seanmason/skadis-designs/animation/v07-assembly/poster.jpg

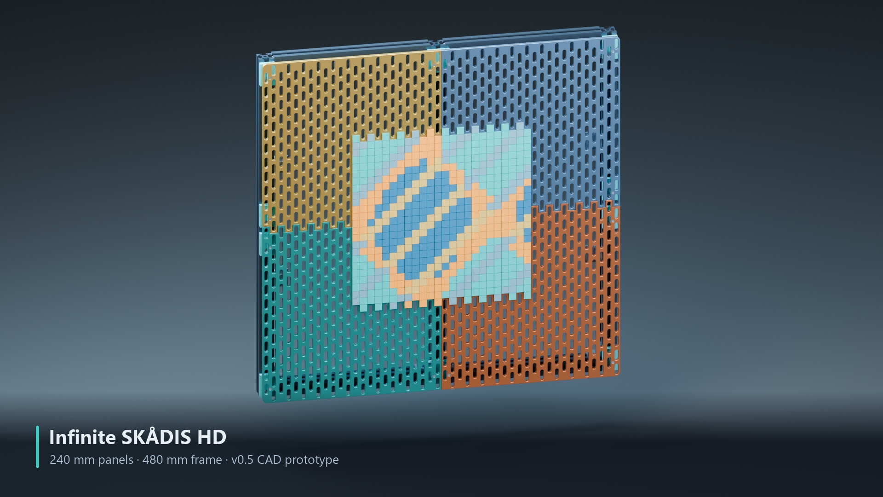
animation/v07-assembly/poster.jpg
