seanmason/skadis-designs/animation/v03-reveal/qa-contact-sheet.jpg

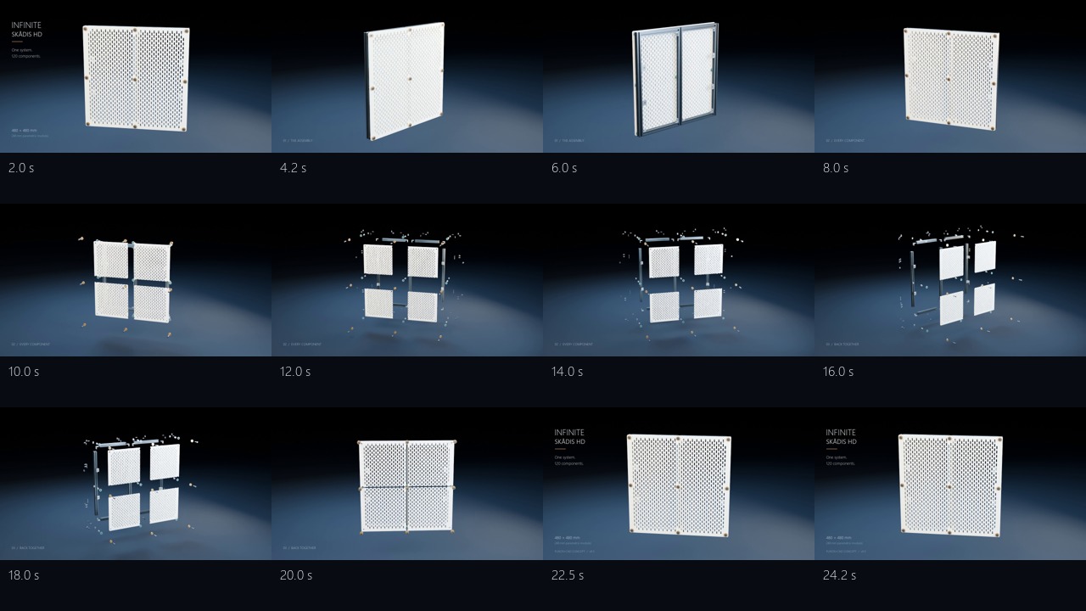
animation/v03-reveal/qa-contact-sheet.jpg
