seanmason/skadis-designs/docs/menards-morton-grove-hardware.md

# Menards Morton Grove hardware lookup

Checked live with **Morton Grove** selected, 2026-10-31 (approximately 9:15–9:35 PM Central). Prices below are before tax and before mail-in rebates. Stock means displayed retail packs, not individual fasteners; inventory can change before arrival. Nothing ordered or reserved.

Store: [6301 Oakton St, Morton Grove, IL 60053](https://www.menards.com/store-details/store.html?store=3523). Main telephone 847-966-1600; hardware department **847-966-2050**. The store page showed Saturday closing at 10 PM.

All four verified stocked items below are **Aisle 183, Section B**.

| Item | Model / SKU | Pack price | Displayed stock | Drawer | Design relevance |
|---|---|---:|---:|---|---|
| [M5-0.80 x 12 mm Phillips flat-head, zinc](https://www.menards.com/main/hardware/fasteners-connectors/screws/machine-screws/midwest-fastener-reg-5mm-0-80-x-12mm-phillips-drive-zinc-flat-head-machine-screw-2-c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) | 88582 / 2012304 | $0.99 / 2 | 3 packs = 6 screws | 89882 | Nominal thread/length/head-style match to the 12 existing carrier fixings. Measure actual head diameter and angle against the 9.4 mm CAD pocket; listing gives no head drawing or rated class. Stock short by 6 screws. |
| [M2-0.40 hex nuts, zinc Class 8](https://www.menards.com/main/hardware/fasteners-connectors/nuts/hex-jam-nuts/midwest-fastener-reg-metric-zinc-class-8-coarse-thread-hex-nuts/87285/p-1444440165809-c-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) | 87285 / 2029854 | $0.59 / 2 | 4 packs = 8 nuts | 89768 | Current M2 design needs 16. Buy only for the M2 trial; dimensions must fit its 4.3 mm track and nominal 1.6 mm nut height. |
| [M3-0.50 x 20 mm hex-drive flat-head, black](https://www.menards.com/main/hardware/fasteners-connectors/screws/socket-cap-screws/midwest-fastener-reg-3mm-0-50-x-20mm-plain-hex-drive-flat-head-coarse-thread-sock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) | 88689 / 2012442 | $1.69 / 2 | 14 packs = 28 screws | 89892 | Candidate for the solid-land revision, NOT a substitution in v0.5. Listing head diameter 5.7 mm, height 1.86 mm, 2 mm hex key. Eight packs give 16 screws for four panels ($13.52). Final stack/engagement must be checked in the revised carrier. |
| [M3-0.50 hex nuts, zinc Class 8](https://www.menards.com/main/hardware/fasteners-connectors/nuts/hex-jam-nuts/midwest-fastener-reg-metric-zinc-class-8-coarse-thread-hex-nuts/87293/p-1444440147817-c-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) | 87293 / 2029862 | $0.59 / 2 | 8 packs = 16 nuts | 89768 | Candidate for the solid-land revision only. DIN 934, 5.5 mm across flats. Eight packs give 16 nuts ($4.72). |

An alternative [M3-0.50 x 20 mm Phillips flat-head](https://www.menards.com/main/hardware/fasteners-connectors/screws/machine-screws/midwest-fastener-reg-3mm-0-50-x-20mm-phillips-drive-zinc-flat-head-machine-screw-3-c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), model 88569 / SKU 2012289, was $0.99 per 3, five packs (15 screws) in stock, drawer 89881. Its exact head envelope was not supplied. Prefer a consistent head type after measuring a sample.

The [20-pack M5 Phillips flat-head](https://www.menards.com/main/hardware/fasteners-connectors/screws/machine-screws/midwest-fastener-reg-5mm-0-80-x-12mm-phillips-drive-zinc-flat-head-machine-screw-20-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), model 72447, was $5.49 but pickup disabled / delivery only, so it is not a confirmed on-site purchase.

## Not a complete on-site bill of materials

- The site's M2 search returned [M2 x 20 slotted **pan-head** screws](https://www.menards.com/main/hardware/fasteners-connectors/screws/machine-screws/midwest-fastener-reg-2mm-0-40-x-20mm-slotted-drive-zinc-pan-head-machine-screw-2-cou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), SKU 2029856, 12 two-packs at $0.89. These are **not** compatible replacements for the current flush countersunk seats. No matching M2 flat-head product was verified.
- The frame requires 24 nominal M5 x 8 button-head screws. Site search found an M5 x 8 **truss-head** option (SKU 2012349), not the modeled button head. Do not substitute without head/tool-clearance verification.
- The assembly needs 36 profile-specific M5 channel nuts: 12 front-carrier nuts plus 24 side-joint/wall-tab nuts. No suitable Menards extrusion nut was verified. The CAD's 8.8 x 12 x 2.7 mm thin-nut envelope is provisional for the measured sloped channel. Woodworking four-prong tee nuts are not substitutes.
- Metal corner brackets, flush wall tabs and four wall-anchor locations are still provisional. Anchor type, length and count cannot be selected from an unspecified wall substrate/load. Do not treat the head-only reference geometry as a purchase specification.
- The optional existing handling tool uses two M2 x 6 flat-head screws; a matching Menards item was not verified.

The M3 items are useful **sample hardware** for a revised mounting station. A complete panel/carrier/jig revision and load qualification remain pending the mounting-layout choice, filament and load target described in [the mounting study](mounting-revision-study.md).

## Online alternatives checked 2026-10-31

Amazon guest product pages were checked with **Morton Grove 60053** selected, around 9:50 PM Central. ZIP and Prime membership have been requested but not confirmed by the user. These are displayed delivery estimates, not reservations or checkout guarantees. Prices exclude tax. No purchases made.

| Product | Pack / price | Delivery displayed | Use and qualification |
|---|---|---|---|
| [Fullerkreg M5-0.8 x 8 button-head, ISO 7380, stainless](https://www.amazon.com/dp/B07H18YDYB) | 100 / $8.89 | Prime Sunday Nov 1; nonmember Thursday Nov 5 with eligible $35 order | 24 required in current four-panel assembly. Listing specifies 8 mm under-head length, 3 mm hex drive, fully threaded, A2 stainless. Best straightforward fast-delivery candidate. Final engagement depends on selected channel nut and actual bracket thickness. |
| [QWUEE M5-0.8 x 12 Phillips flat-head, stainless](https://www.amazon.com/dp/B0D8PPQPBX) | 30 / $6.89 | Prime Monday Nov 2; nonmember Thursday Nov 5 with eligible $35 order | 12 current carrier screws. Thread, length and head style match nominally; head diameter and countersink angle are not specified. Verify against 9.4 mm CAD seat before bulk use. Title incorrectly says UNC, but bullet explicitly specifies metric 5 mm diameter / 0.8 mm pitch / 12 mm including head. |
| [QWUEE M2-0.4 x 20 Phillips flat-head, stainless](https://www.amazon.com/dp/B0D8PRMRRV) | 50 / $7.29 | Prime Monday Nov 2; nonmember Thursday Nov 5 with eligible $35 order | 16 current panel screws, only for M2 prototypes pending mounting revision. Confirm head fits 4.0 mm seat. Listing's UNC wording conflicts with explicit metric diameter/pitch; not a dimensionally certified supplier drawing. |
| [ZQZ metric hex nut assortment, stainless](https://www.amazon.com/dp/B0B17LL6WZ) | 370 / $15.99 | Prime Sunday Nov 1; nonmember Thursday Nov 5 with eligible $35 order | Includes 70 M2 and 70 M3, enough for either 16-nut panel-mount option. Check across-flats and height against printed capture before use. Its ordinary M5 hex nuts are NOT substitutes for extrusion channel nuts. |
| [QWUEE M3-0.5 x 20 Phillips flat-head, stainless](https://www.amazon.com/dp/B0D8PQTP94) | 50 / $7.29 | Thursday Nov 5 shown; no earlier Prime promise visible | Conditional candidate for proposed M3 solid-land revision, not current v0.5. Only one pack shown. Final head dimensions and carrier stack remain unqualified. |

The M5 x 8 screws, M5 x 12 screws, M2 x 20 screws and nut assortment total **$39.06 before tax**, but this is a prototype sourcing basket, not a complete or released assembly BOM. Do not buy both panel-screw diameters assuming interchangeability.

### Extrusion nuts: unresolved fit

[Boeray 20-M5 slide-in nuts, 50 pack](https://www.amazon.com/dp/B01GCDG2QO) were $7.99, with Prime Sunday Nov 1 / nonmember Thursday Nov 5 delivery displayed. This is **not a qualified recommendation**. The bullet claims 10 mm length, 9 mm width, 4.5 mm height with a 6 x 1.5 mm step, while the description says 10 x 10 x 5 mm. It is end-loaded, not front-loaded. Neither conflicting envelope establishes clearance in the measured sloped channel, bearing under its lips, or adequate screw engagement without bottoming. The assembly needs 36 verified channel nuts. A physical sample and section comparison are needed before choosing this product or revising the nut envelope.

### Fast alternative: McMaster-Carr

McMaster's [delivery policy](https://www.mcmaster.com/info/delivery) says 98% of items ship from stock and most orders arrive same or next day. This is a general policy, not an item-specific delivery promise. Its [Chicago contact page](https://www.mcmaster.com/contact) lists will call at **600 N County Line Rd, Elmhurst IL 60126**, phone **630-600-3600**; Sunday hours **7 AM–2 PM**, Monday–Thursday **6 AM–10 PM**, Friday **6 AM–6 PM**, Saturday **7 AM–2 PM**. Confirm order readiness before travel. Exact McMaster SKUs, stock and shipment dates were not verified in this lookup.

Wall anchors and final metal bracket specifications remain unresolved as above. None of these listings establishes an allowable load for the printed assembly.
