seanmason/skadis-designs/animation/v03-reveal/poster.png

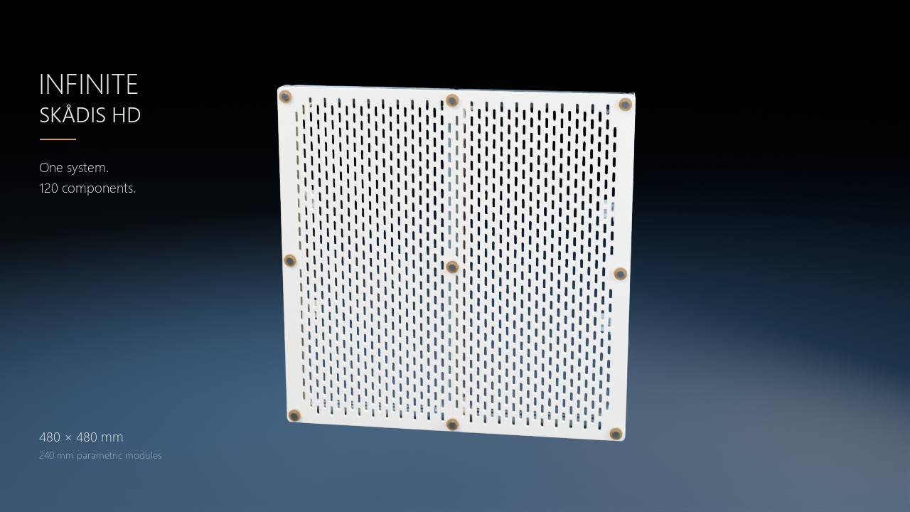
animation/v03-reveal/poster.png
