seanmason/skadis-designs/animation/v04-metallic/contact-sheet.jpg

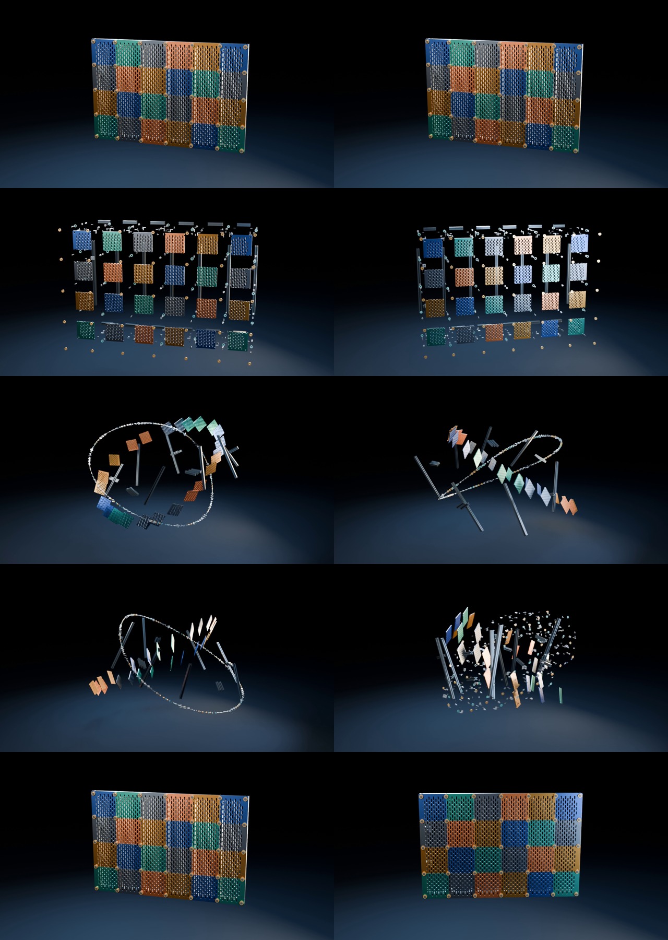
animation/v04-metallic/contact-sheet.jpg
