seanmason/skadis-designs/animation/v04-metallic/whirlwind.png

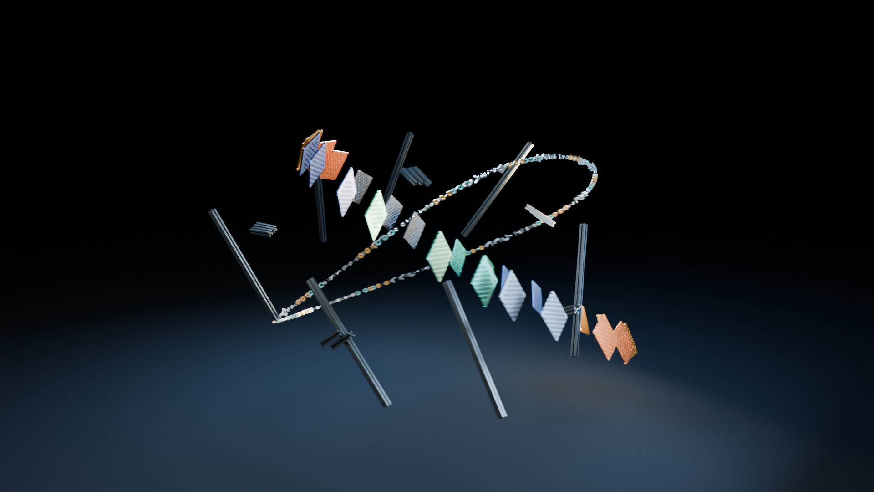
animation/v04-metallic/whirlwind.png
