seanmason/skadis-designs/animation/v04-review/exploded.png

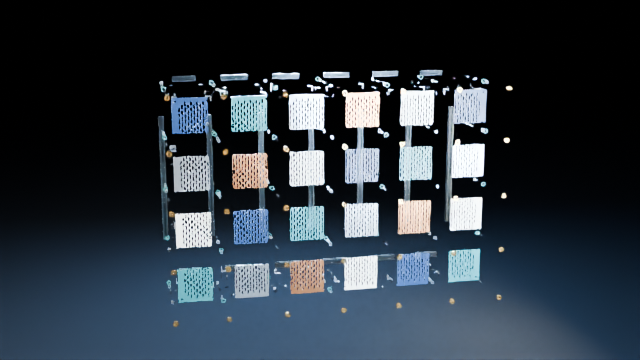
animation/v04-review/exploded.png
