seanmason/skadis-designs/animation/v05-smooth/regression-contact-sheet.jpg

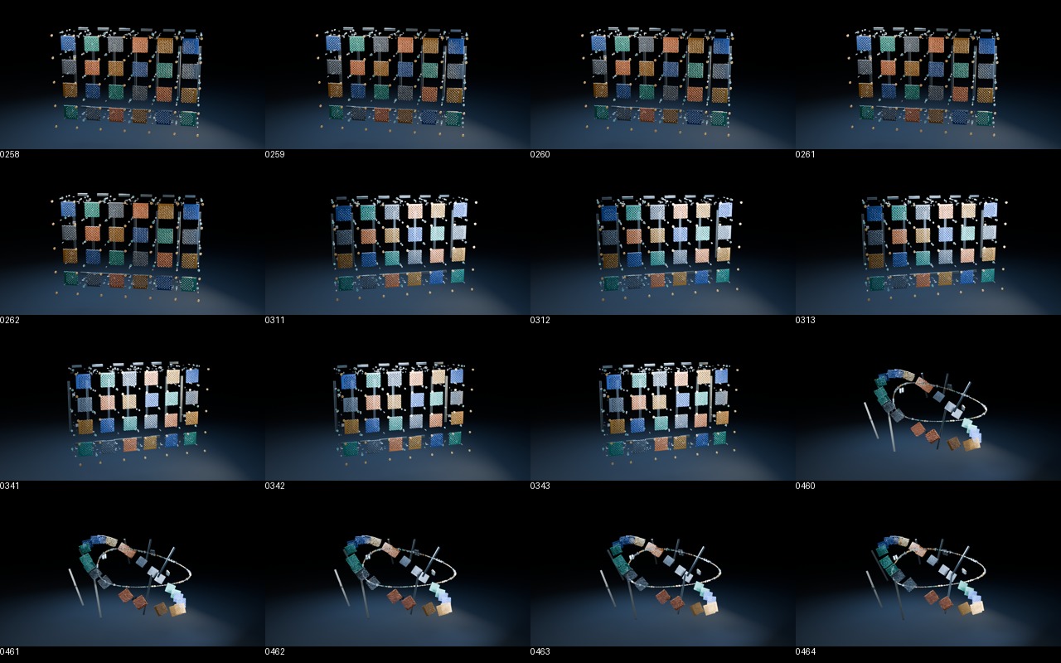
animation/v05-smooth/regression-contact-sheet.jpg
