seanmason/skadis-designs/models/mounting-study/comparison.png

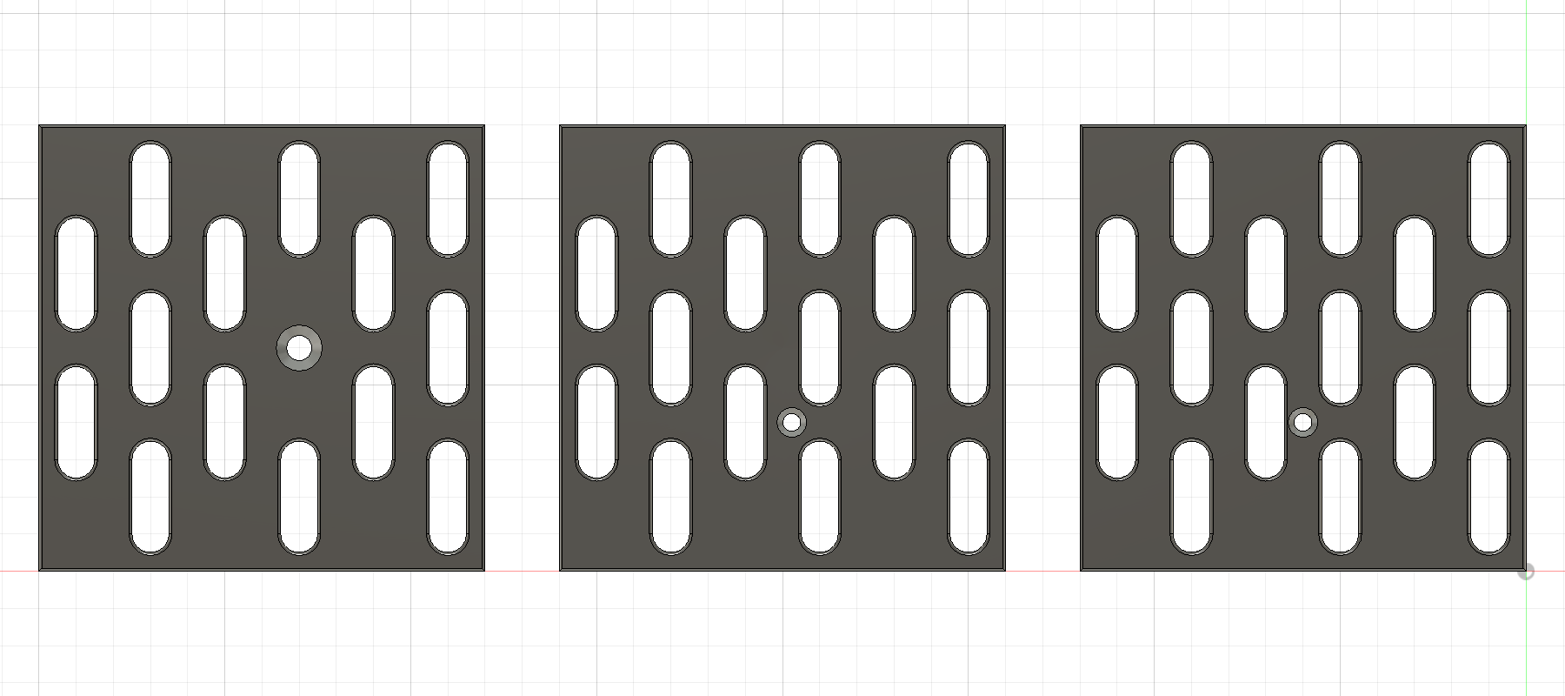
models/mounting-study/comparison.png
