seanmason/skadis-designs/models/v04-study/front.png

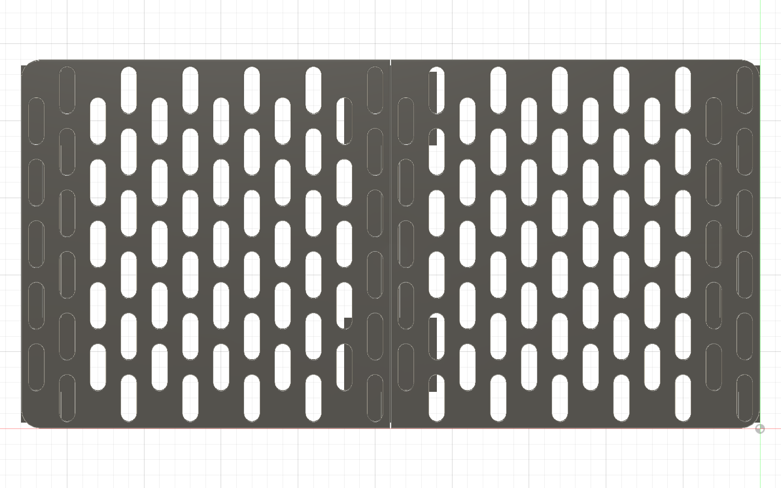
models/v04-study/front.png
