seanmason/skadis-designs/models/v04-study/study.png

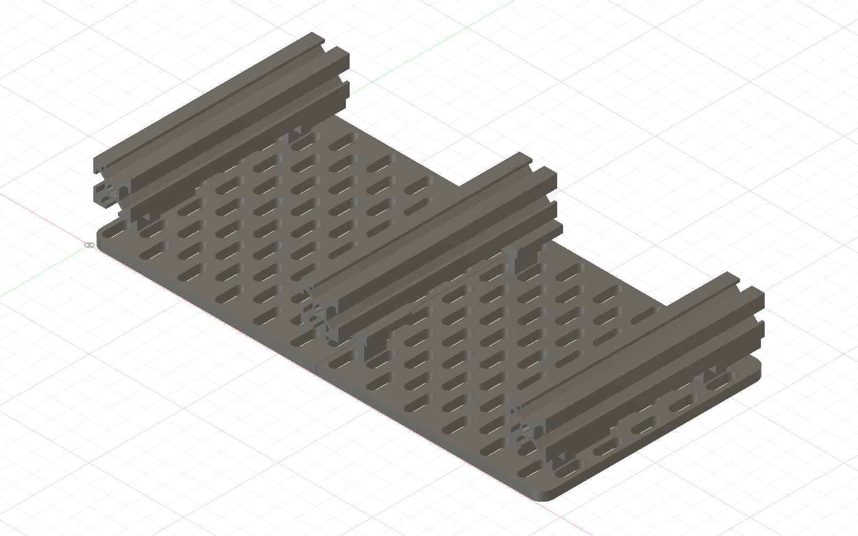
models/v04-study/study.png
