seanmason/skadis-designs/models/v061/fit-kit/preview.png

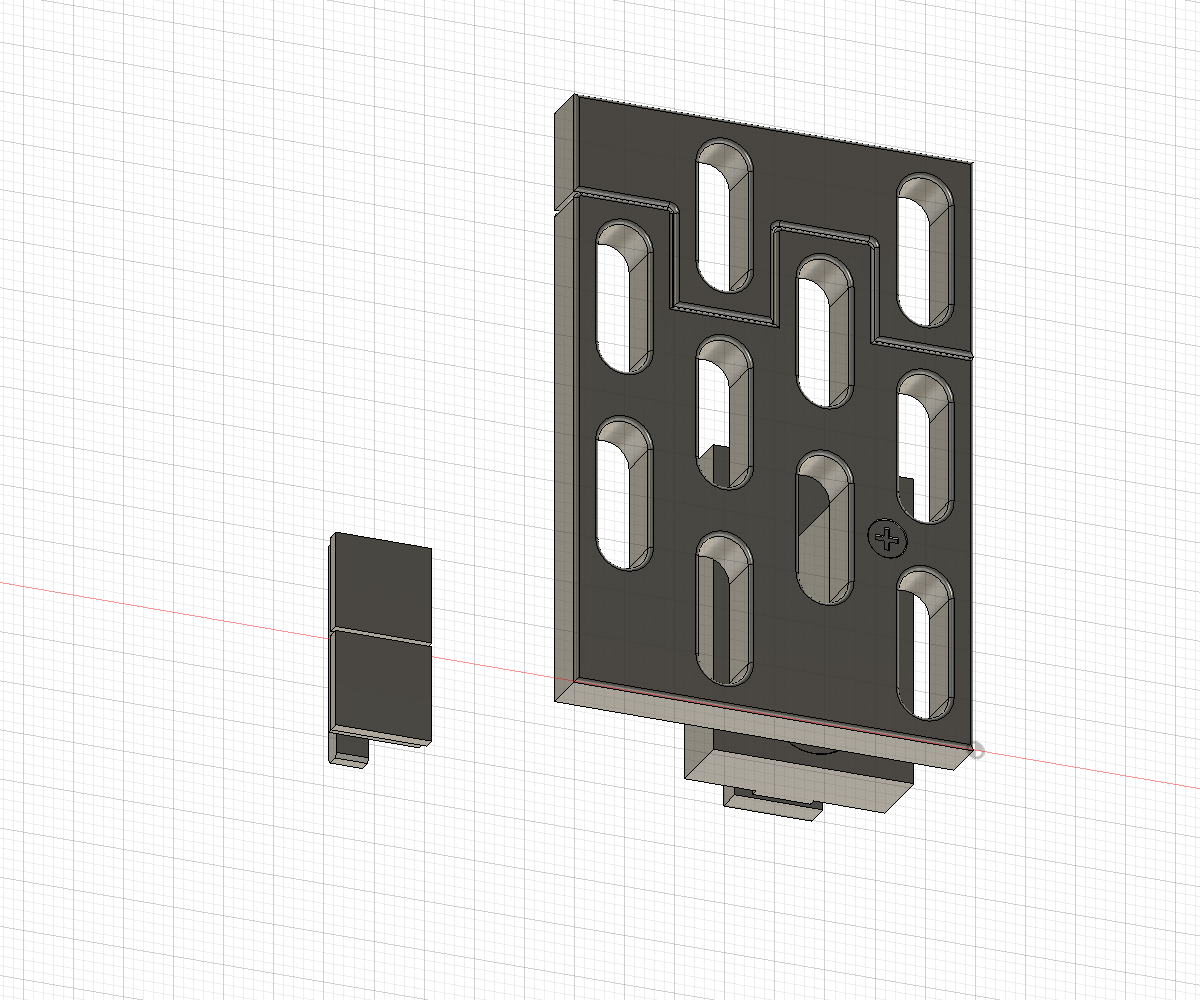
models/v061/fit-kit/preview.png
