seanmason/skadis-designs/previews/master-rear.png

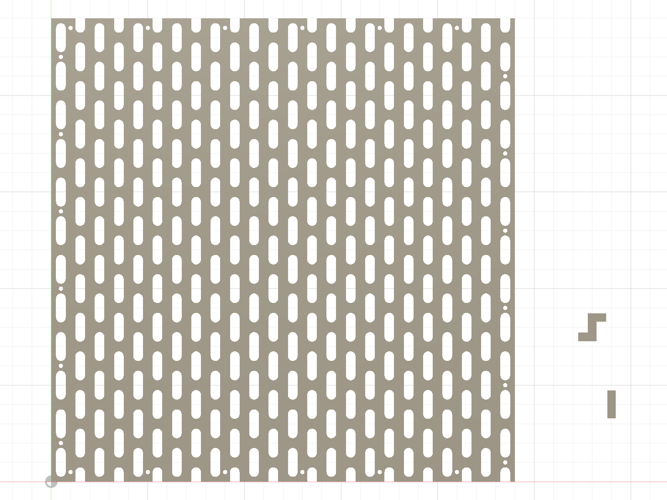
previews/master-rear.png
