seanmason/skadis-designs/previews/v02-face.png

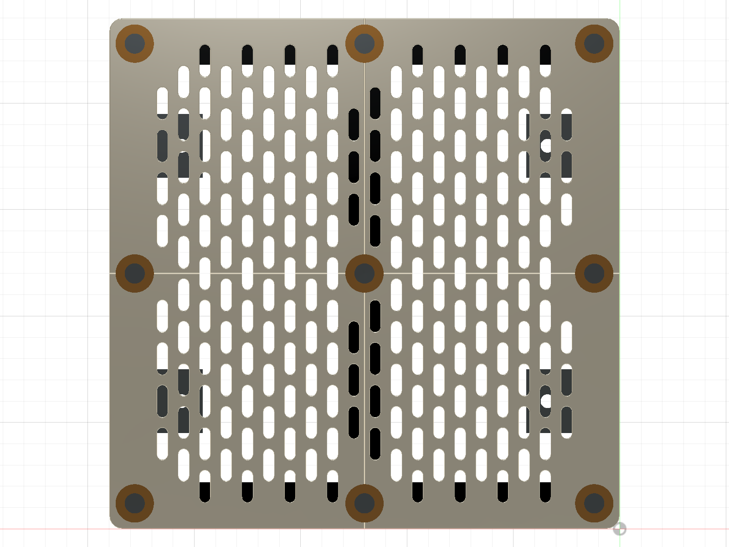
previews/v02-face.png
