seanmason/skadis-designs/previews/v02-rear.png

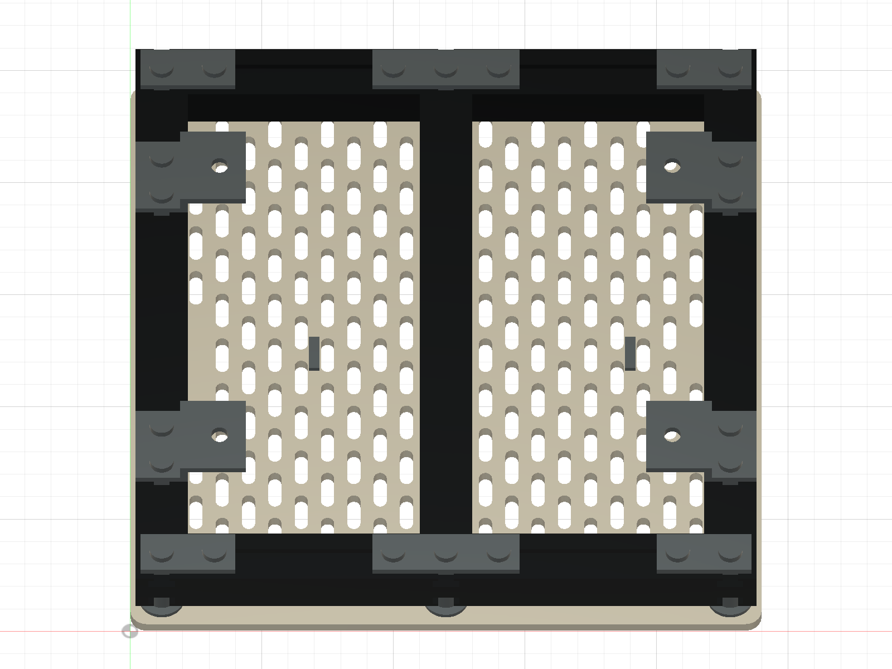
previews/v02-rear.png
