seanmason/skadis-designs/previews/v02-side.png

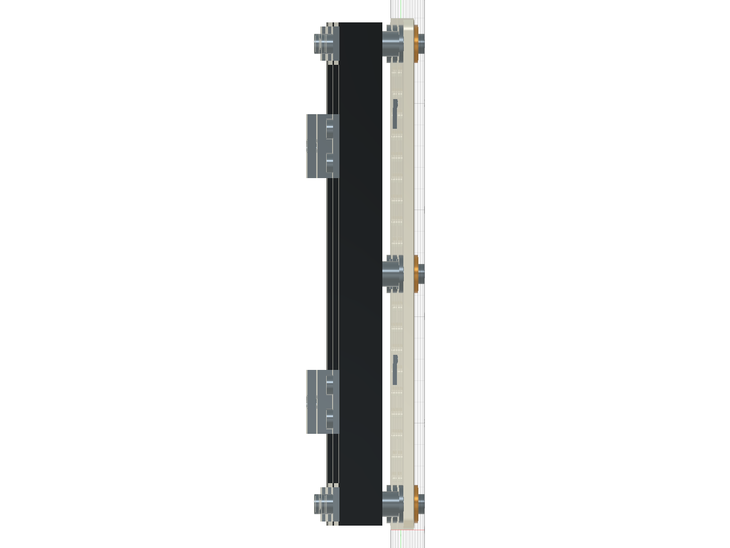
previews/v02-side.png
