seanmason/skadis-designs/previews/v03-bare-frame.png

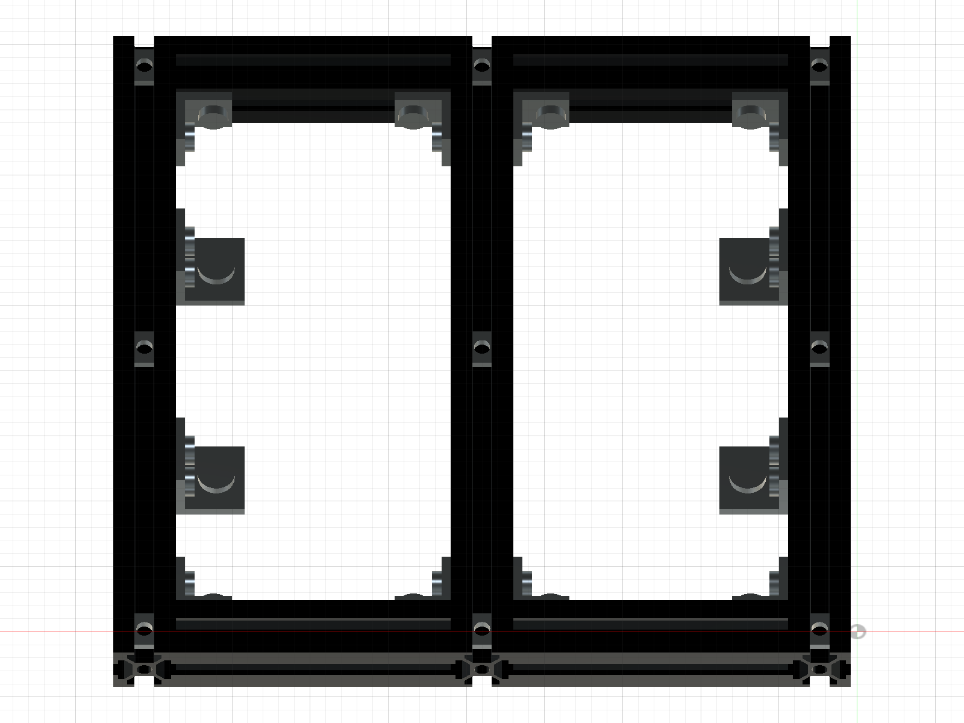
previews/v03-bare-frame.png
