seanmason/skadis-designs/previews/v03-front.png

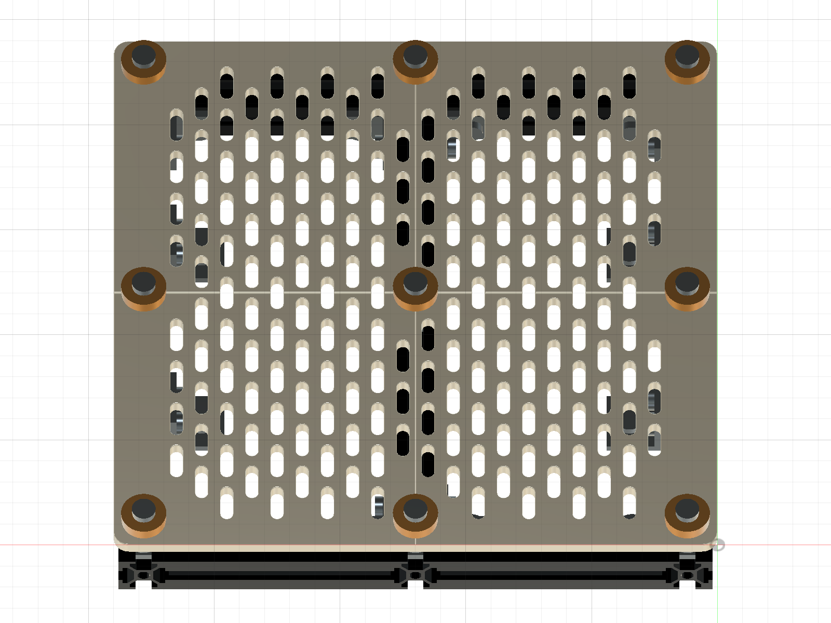
previews/v03-front.png
