seanmason/skadis-designs/previews/v03-rear.png

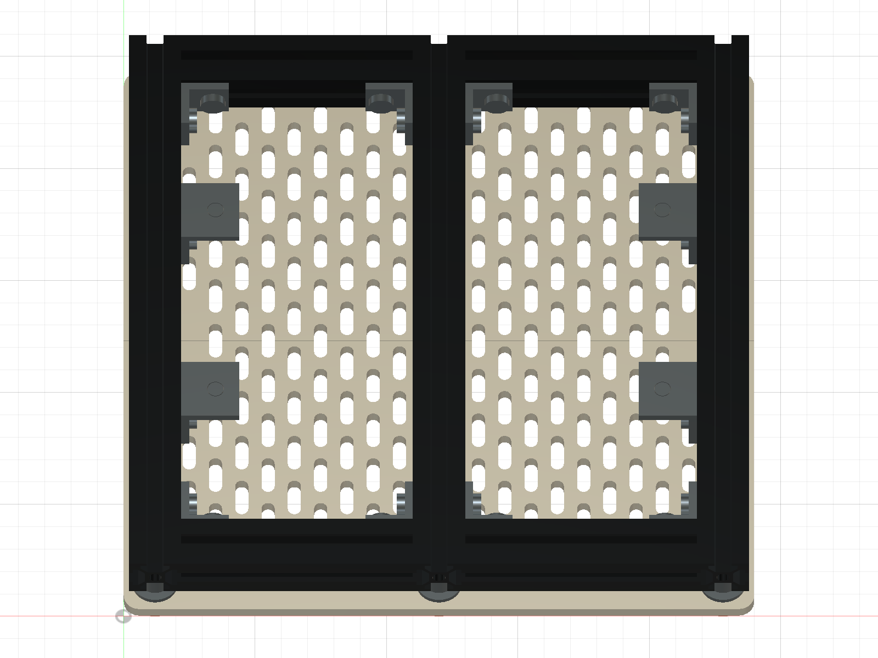
previews/v03-rear.png
