seanmason/skadis-designs/animation/v03-reveal/meshes/087.stl

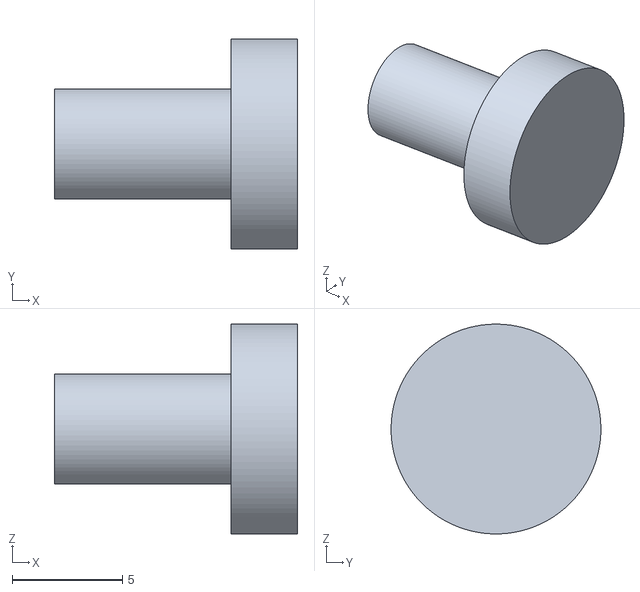
[picture p19: CAD file, 2026-10-29]
animation/v03-reveal/meshes/087.stl
11.0 x 9.50 x 9.50
