seanmason/skadis-designs/animation/v07-assembly/assets/panel-handling-tool-concept--PRINT-quarter-turn-key-0-mm.stl

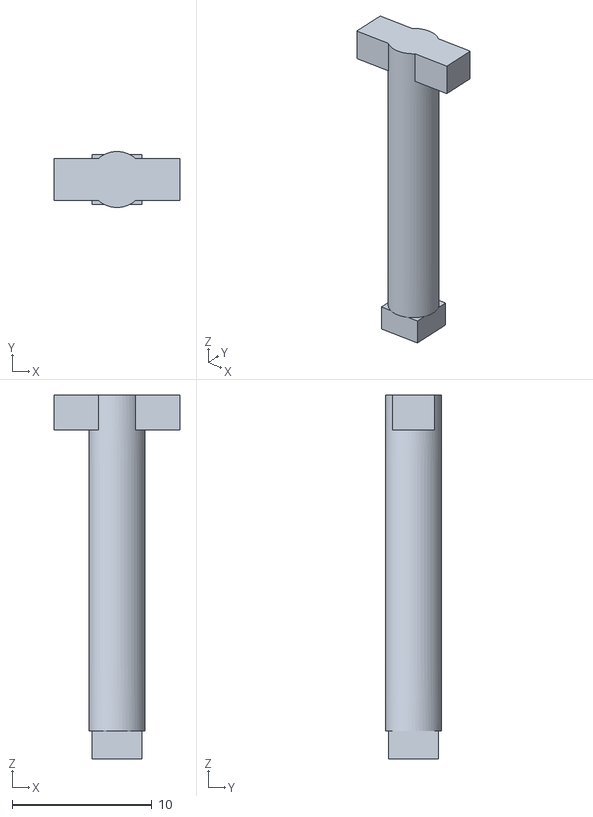
[picture p20: CAD file, 2026-10-31]
animation/v07-assembly/assets/panel-handling-tool-concept--PRINT-quarter-turn-key-0-mm.stl
9.00 x 4.00 x 26.0
