seanmason/skadis-designs/models/mounting-study/Solid-land-M3.stl

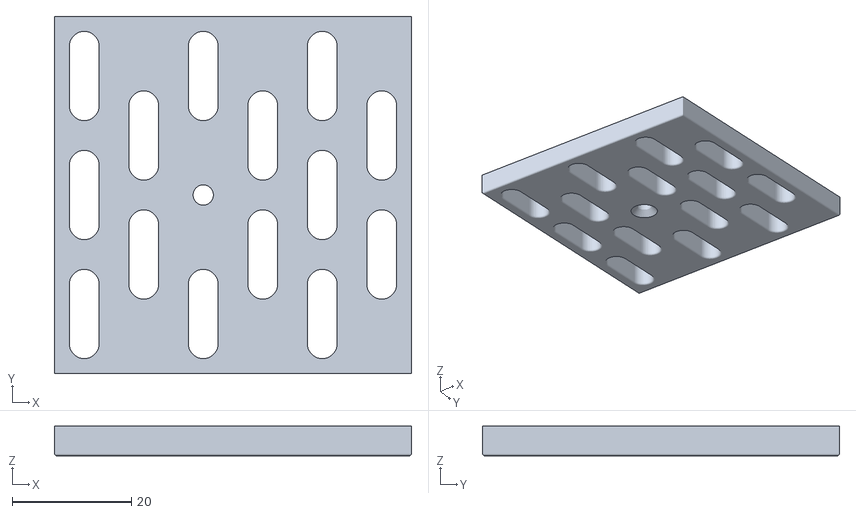
[picture p21: CAD file, 2026-11-01]
models/mounting-study/Solid-land-M3.stl
60.0 x 60.0 x 5.00
