seanmason/skadis-designs/models/panel-240x240.step

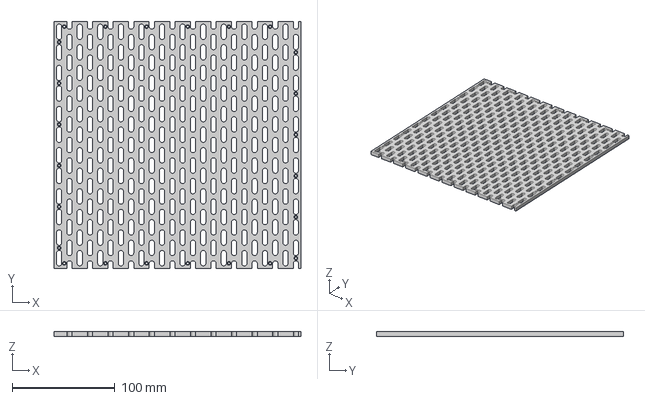
[picture p22: CAD file, 2026-10-27]
models/panel-240x240.step
240.0 x 240.0 x 5.00 mm
