seanmason/skadis-designs/models/v04-study/connector-clearance-study.step

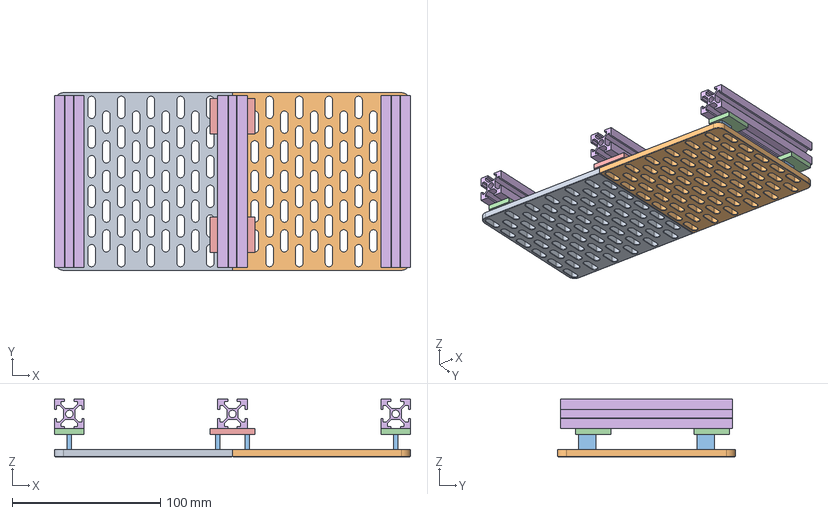
[picture p23: CAD file, 2026-10-29]
models/v04-study/connector-clearance-study.step
240.0 x 119.8 x 39.0 mm
