seanmason/skadis-designs/models/v061/fit-kit/skadis-v061-mk4s-side.3mf

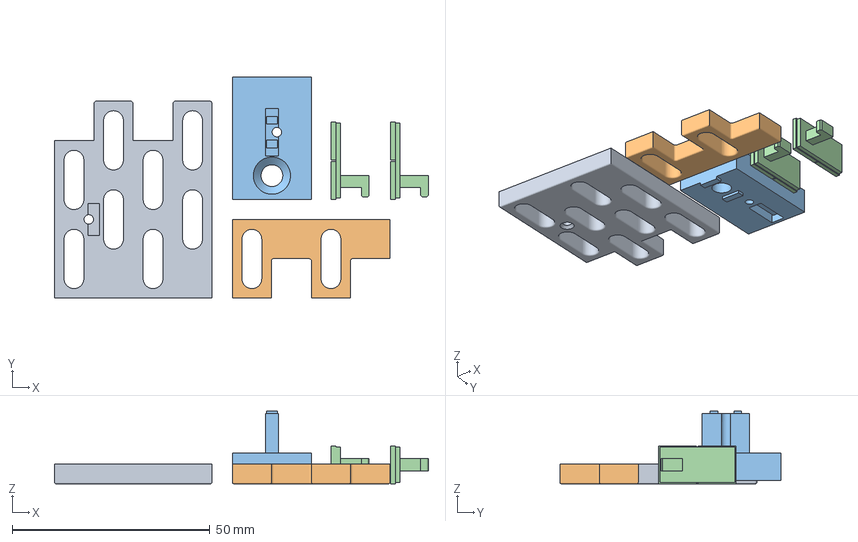
[picture p24: CAD file, 2026-11-04]
models/v061/fit-kit/skadis-v061-mk4s-side.3mf
94.6 x 56.0 x 18.4 mm
01-mount-coupon
02-seam-mate
03-single-carrier
04-two-pixel-tile x 2
