seanmason/skadis-designs/animation/v03-reveal/meshes/102.stl

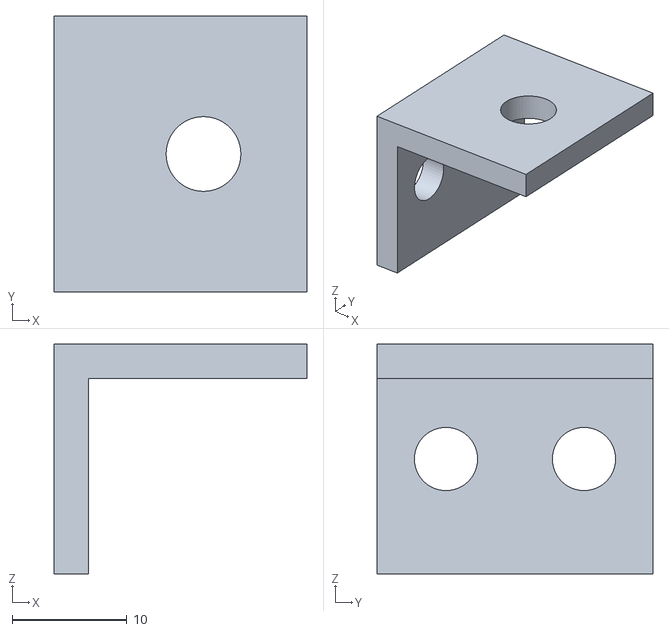
[picture p25: CAD file, 2026-10-29]
animation/v03-reveal/meshes/102.stl
22.0 x 24.0 x 20.0
