seanmason/skadis-designs/animation/v07-assembly/assets/axial-mosaic-tile--PRINT-tile-core.stl

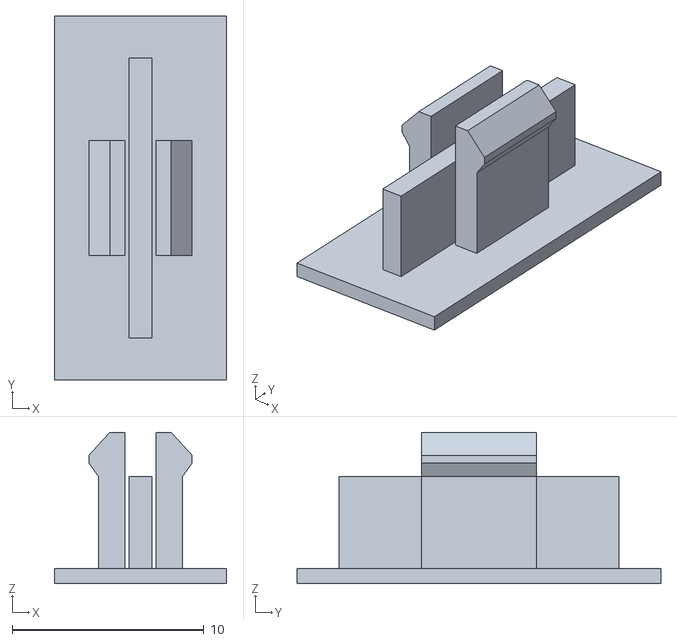
[picture p26: CAD file, 2026-10-31]
animation/v07-assembly/assets/axial-mosaic-tile--PRINT-tile-core.stl
9.00 x 19.0 x 7.90
