seanmason/skadis-designs/animation/v07-assembly/meshes/part-036.stl

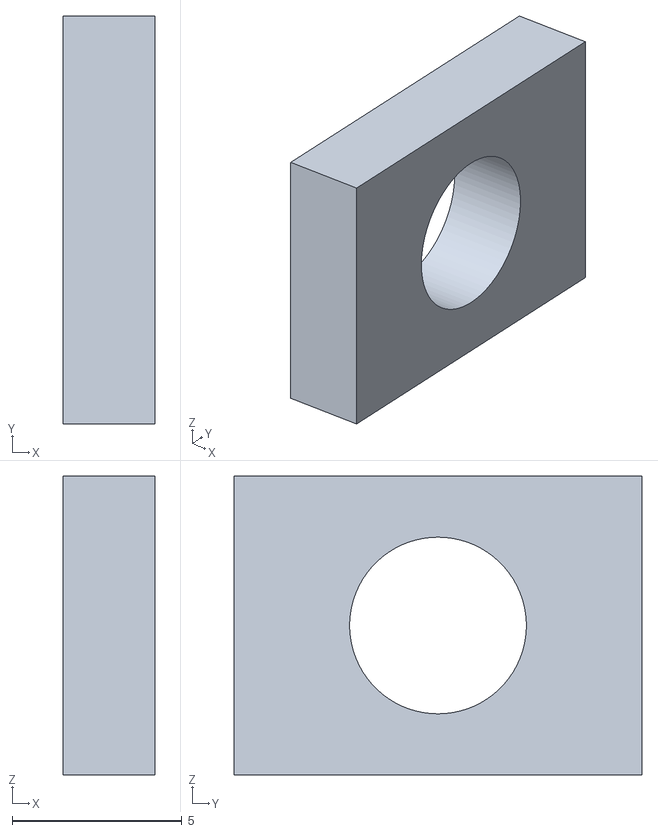
[picture p27: CAD file, 2026-10-31]
animation/v07-assembly/meshes/part-036.stl
2.70 x 12.0 x 8.80
