seanmason/skadis-designs/models/bridge-horizontal.step

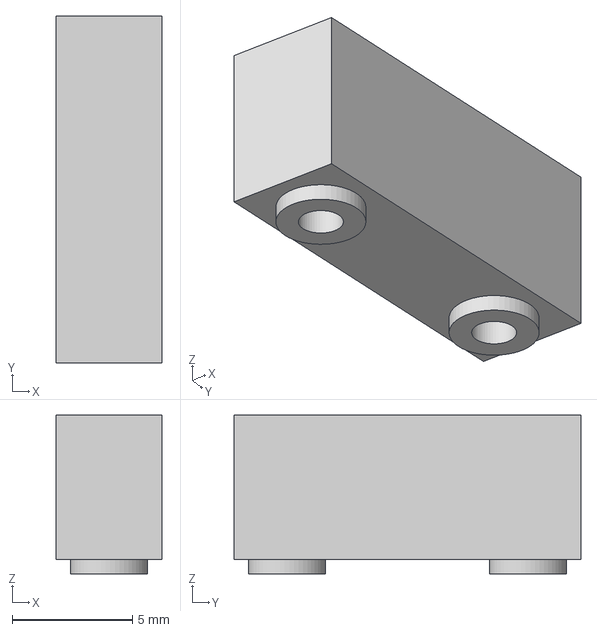
[picture p28: CAD file, 2026-10-27]
models/bridge-horizontal.step
4.40 x 14.4 x 6.60 mm
