seanmason/skadis-designs/animation/v03-reveal/meshes/027.stl

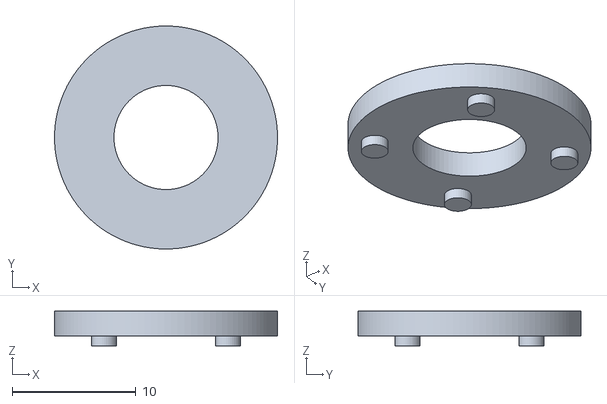
[picture p29: CAD file, 2026-10-29]
animation/v03-reveal/meshes/027.stl
18.0 x 18.0 x 2.80
