seanmason/skadis-designs/animation/v07-assembly/assets/panel-handling-tool-concept--PRINT-thumb-knob-0-mm.stl

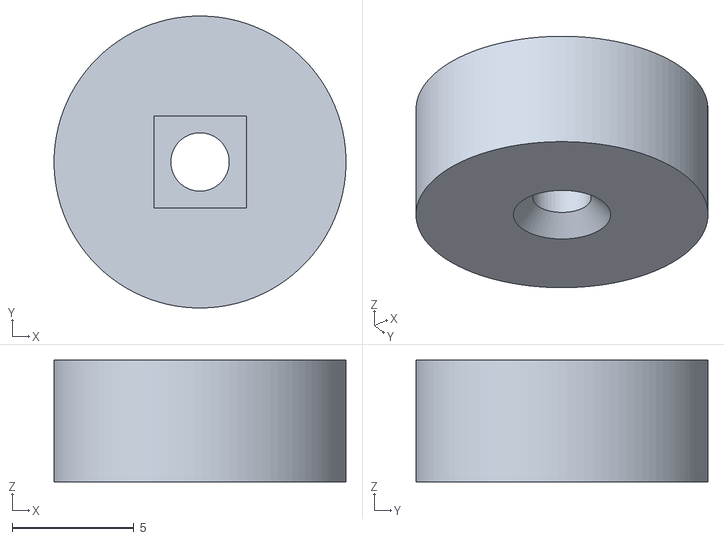
[picture p30: CAD file, 2026-10-31]
animation/v07-assembly/assets/panel-handling-tool-concept--PRINT-thumb-knob-0-mm.stl
12.0 x 12.0 x 5.00
