seanmason/skadis-designs/animation/v07-assembly/meshes/part-046.stl

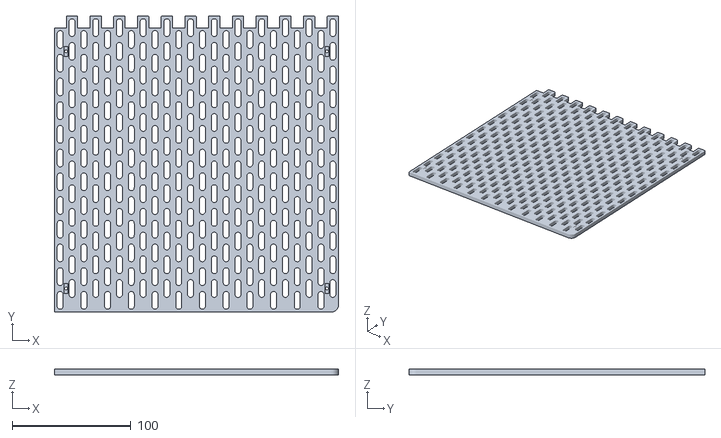
[picture p31: CAD file, 2026-10-31]
animation/v07-assembly/meshes/part-046.stl
239.7 x 249.6 x 5.00
