seanmason/skadis-designs/models/panel-fit-coupon-80x80.step

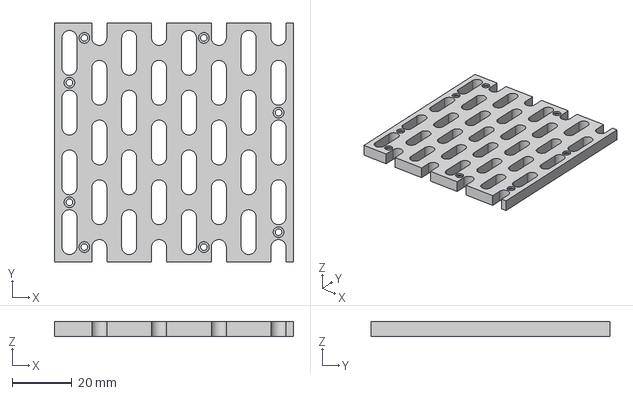
[picture p32: CAD file, 2026-10-27]
models/panel-fit-coupon-80x80.step
80.0 x 80.0 x 5.00 mm
