seanmason/skadis-designs/models/v061/fit-kit/fit-kit-v061.step

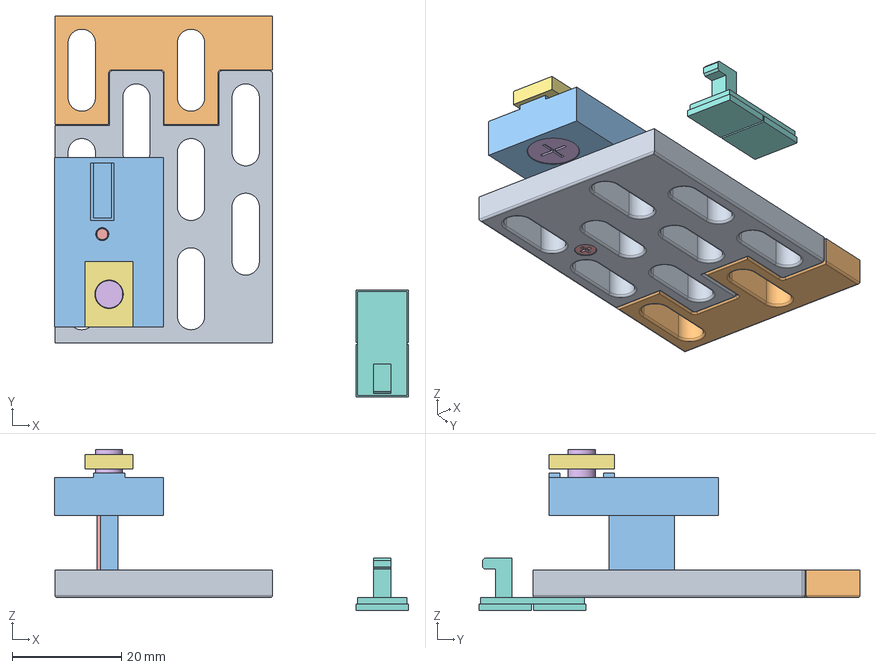
[picture p33: CAD file, 2026-11-04]
models/v061/fit-kit/fit-kit-v061.step
64.8 x 69.7 x 29.5 mm
