seanmason/skadis-designs/animation/v07-assembly/assets/axial-mosaic-tile--COLOR-pixel-upper.stl

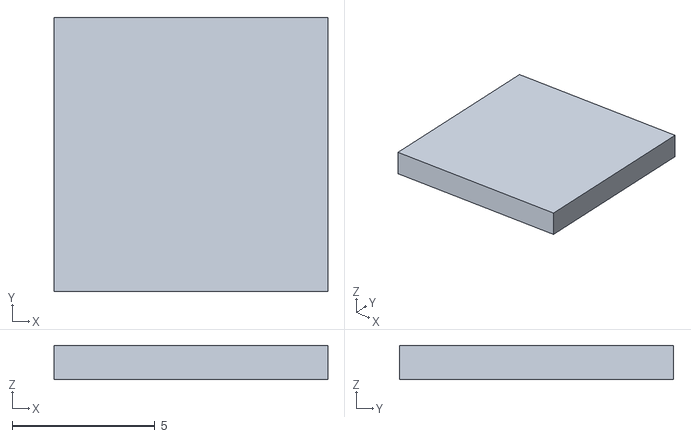
[picture p34: CAD file, 2026-10-31]
animation/v07-assembly/assets/axial-mosaic-tile--COLOR-pixel-upper.stl
9.60 x 9.60 x 1.20
