seanmason/skadis-designs/animation/v07-assembly/meshes/part-017.stl

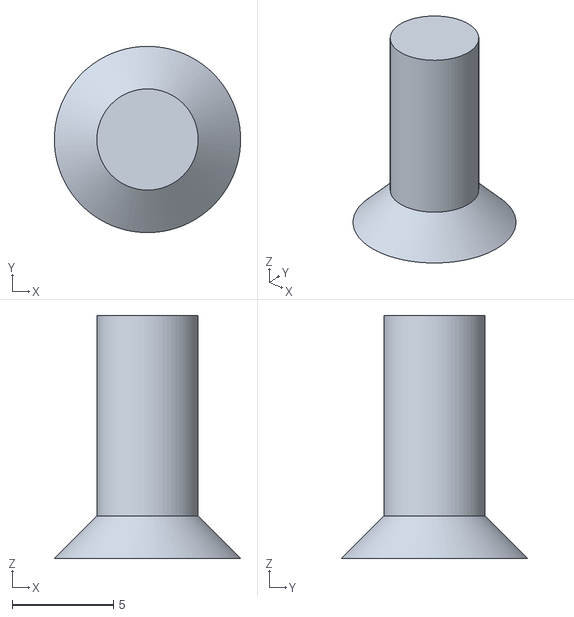
[picture p35: CAD file, 2026-10-31]
animation/v07-assembly/meshes/part-017.stl
9.20 x 9.19 x 12.0
