seanmason/skadis-designs/models/bridge-vertical.step

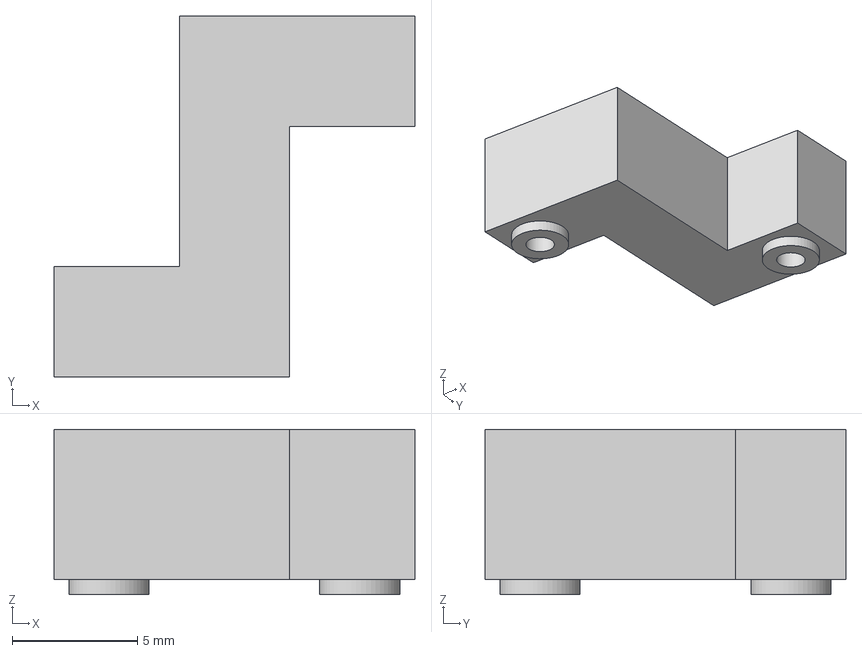
[picture p36: CAD file, 2026-10-27]
models/bridge-vertical.step
14.4 x 14.4 x 6.60 mm
