seanmason/skadis-designs/models/v061/fit-kit/04-two-pixel-tile.stl

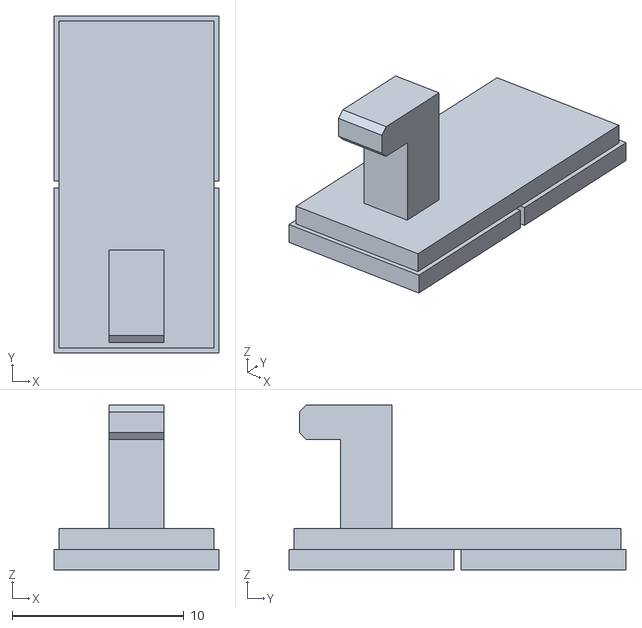
[picture p37: CAD file, 2026-11-04]
models/v061/fit-kit/04-two-pixel-tile.stl
9.60 x 19.6 x 9.60
