seanmason/skadis-designs/animation/v07-assembly/assets/panel-handling-tool-concept--PRINT-handle-bridge.stl

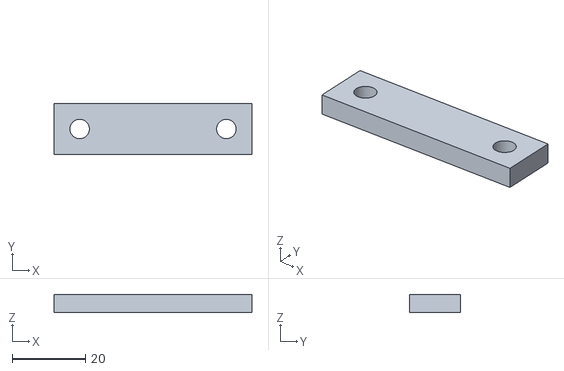
[picture p38: CAD file, 2026-10-31]
animation/v07-assembly/assets/panel-handling-tool-concept--PRINT-handle-bridge.stl
54.0 x 14.0 x 5.00
