seanmason/skadis-designs/animation/v07-assembly/meshes/part-004.stl

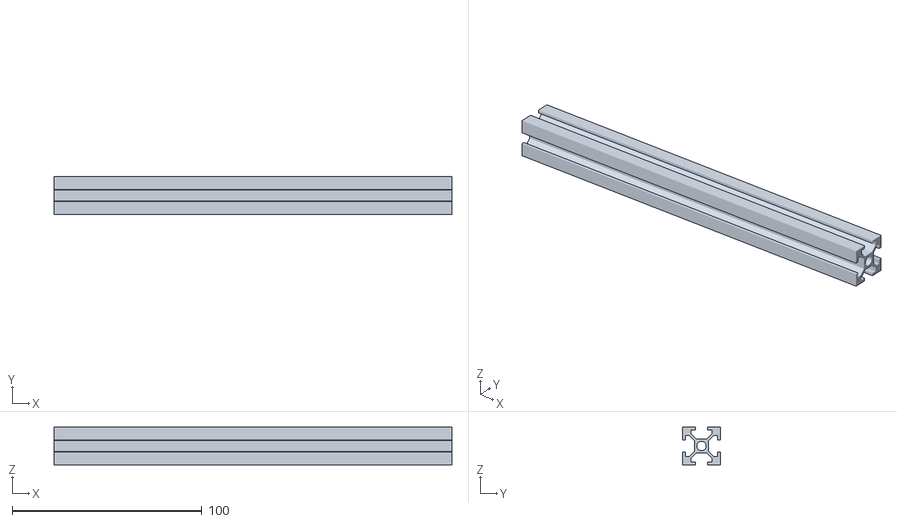
[picture p39: CAD file, 2026-10-31]
animation/v07-assembly/meshes/part-004.stl
210.0 x 20.0 x 20.0
