seanmason/skadis-designs/models/v061/fit-kit/01-mount-coupon.stl

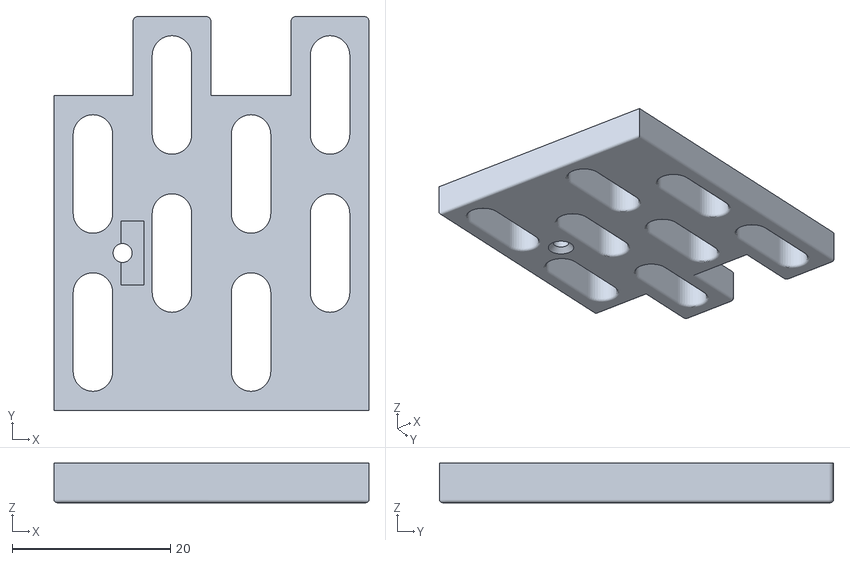
[picture p40: CAD file, 2026-11-04]
models/v061/fit-kit/01-mount-coupon.stl
39.8 x 49.8 x 5.00
