seanmason/skadis-designs/animation/v03-reveal/meshes/081.stl

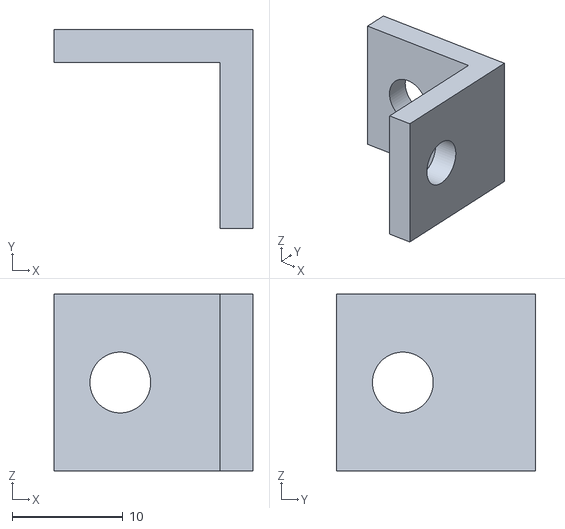
[picture p41: CAD file, 2026-10-29]
animation/v03-reveal/meshes/081.stl
18.0 x 18.0 x 16.0
