seanmason/skadis-designs/animation/v07-assembly/assets/panel-handling-tool-concept--REFERENCE-handle-M2x6-handlePitch.stl

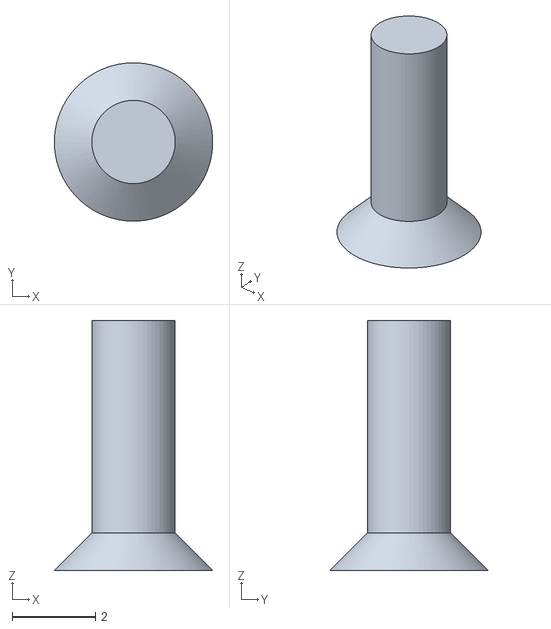
[picture p42: CAD file, 2026-10-31]
animation/v07-assembly/assets/panel-handling-tool-concept--REFERENCE-handle-M2x6-handlePitch.stl
3.80 x 3.80 x 6.00
