seanmason/skadis-designs/models/v061/fit-kit/02-seam-mate.stl

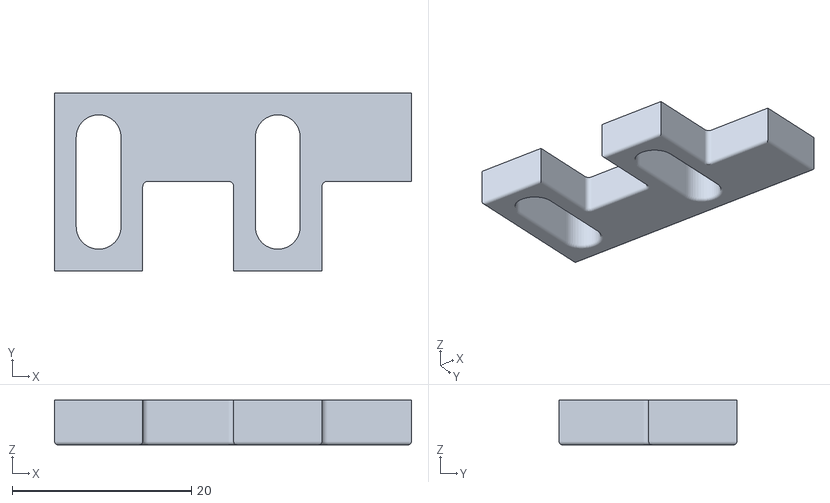
[picture p43: CAD file, 2026-11-04]
models/v061/fit-kit/02-seam-mate.stl
39.8 x 19.8 x 5.00
