seanmason/skadis-designs/animation/v07-assembly/assets/carrier-jig-240--PRINT-alignment-jig.stl

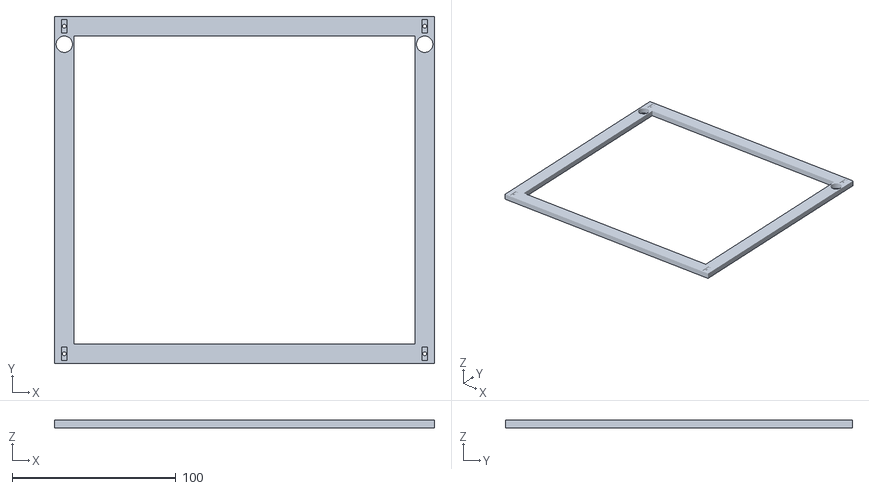
[picture p44: CAD file, 2026-10-31]
animation/v07-assembly/assets/carrier-jig-240--PRINT-alignment-jig.stl
232.0 x 212.0 x 5.00
