seanmason/skadis-designs/animation/v07-assembly/meshes/part-015.stl

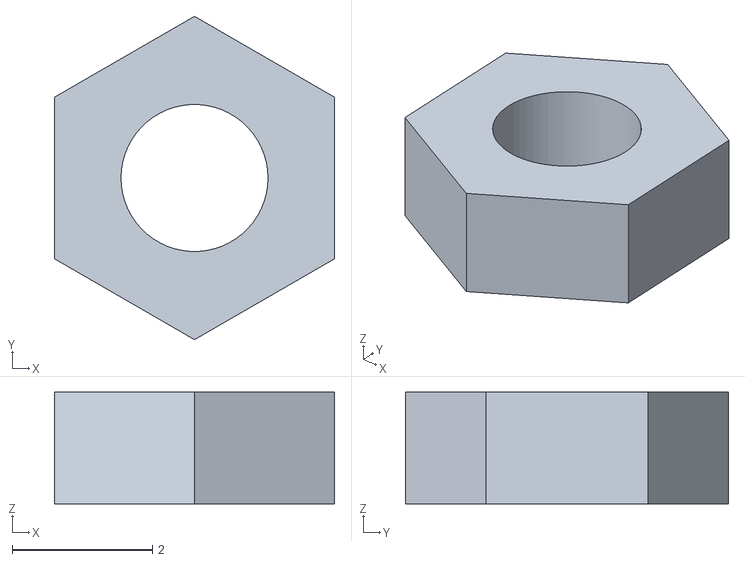
[picture p45: CAD file, 2026-10-31]
animation/v07-assembly/meshes/part-015.stl
4.00 x 4.62 x 1.60
