seanmason/skadis-designs/models/v061/fit-kit/03-single-carrier.stl

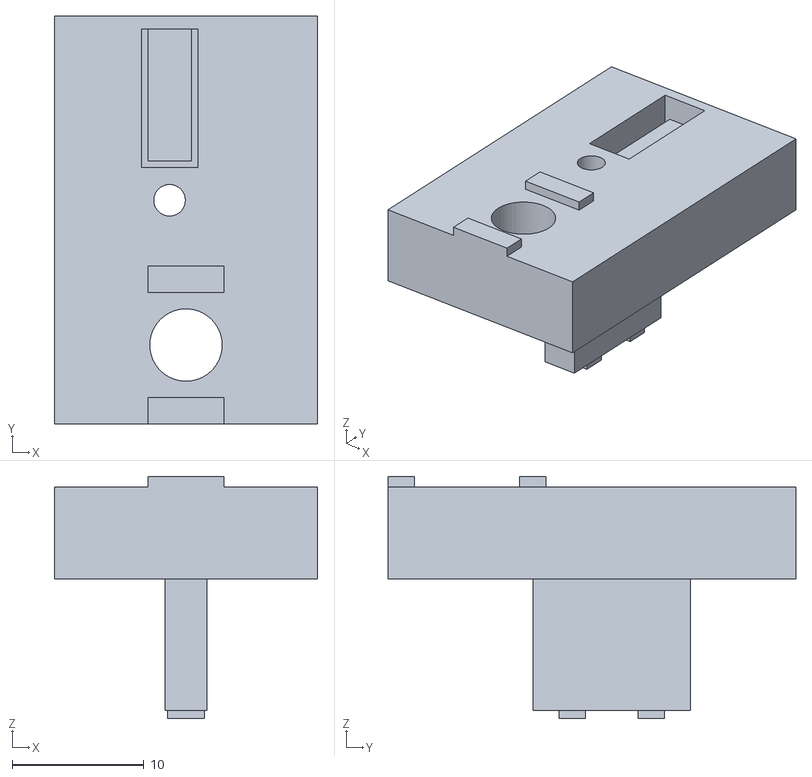
[picture p46: CAD file, 2026-11-01]
models/v061/fit-kit/03-single-carrier.stl
20.0 x 31.0 x 18.4
