seanmason/skadis-designs/animation/v03-reveal/meshes/029.stl

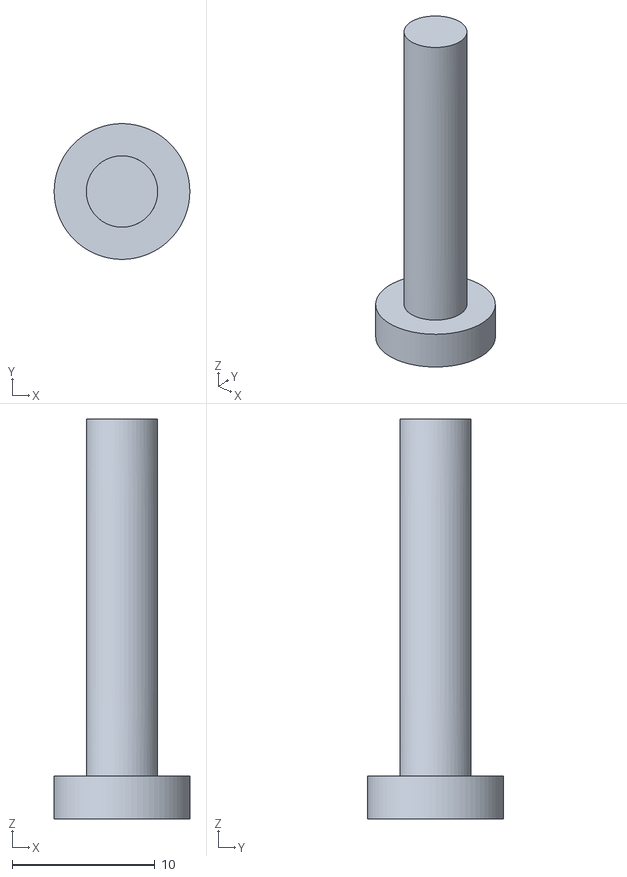
[picture p47: CAD file, 2026-10-29]
animation/v03-reveal/meshes/029.stl
9.50 x 9.49 x 28.0
