seanmason/skadis-designs/animation/v03-reveal/meshes/011.stl

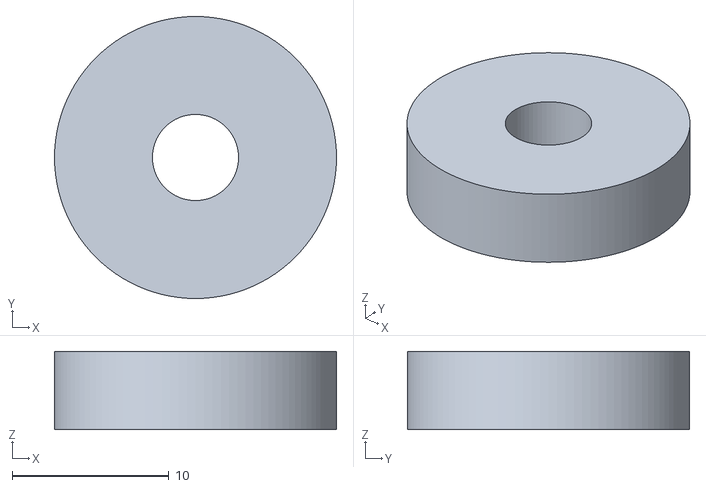
[picture p48: CAD file, 2026-10-29]
animation/v03-reveal/meshes/011.stl
18.0 x 18.0 x 5.00
