seanmason/skadis-designs/animation/v03-reveal/meshes/113.stl

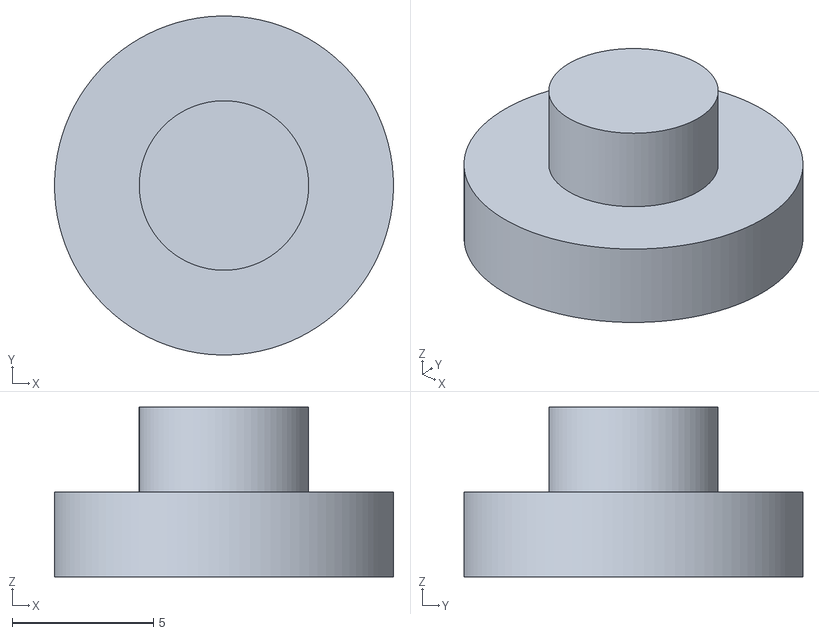
[picture p49: CAD file, 2026-10-29]
animation/v03-reveal/meshes/113.stl
12.0 x 12.0 x 6.00
