seanmason/skadis-designs/animation/v07-assembly/meshes/part-001.stl

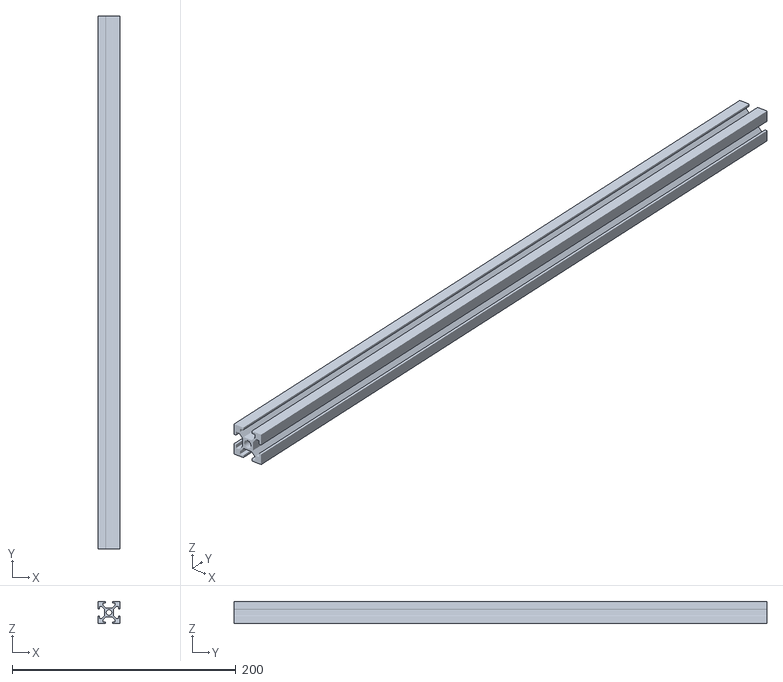
[picture p50: CAD file, 2026-10-31]
animation/v07-assembly/meshes/part-001.stl
20.0 x 476.0 x 20.0
