seanmason/skadis-designs/animation/v07-assembly/meshes/part-012.stl

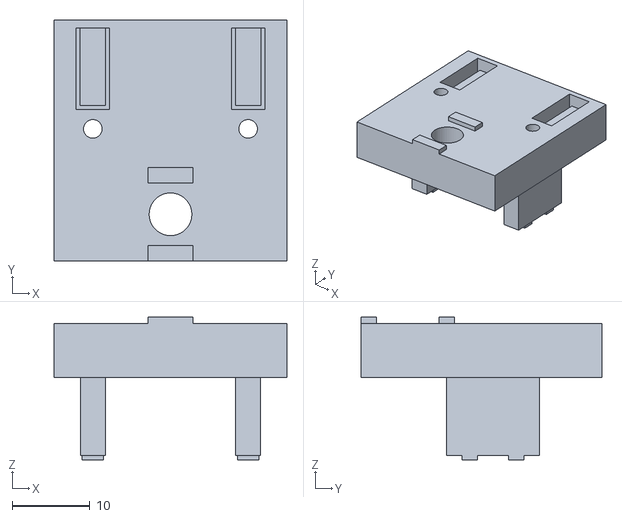
[picture p51: CAD file, 2026-10-31]
animation/v07-assembly/meshes/part-012.stl
30.0 x 31.0 x 18.4
