seanmason/skadis-designs/animation/v07-assembly/meshes/part-026.stl

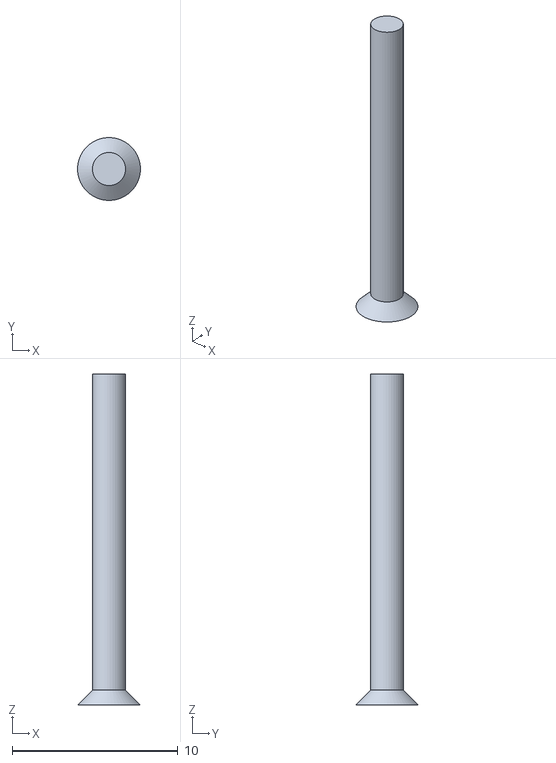
[picture p52: CAD file, 2026-10-31]
animation/v07-assembly/meshes/part-026.stl
3.80 x 3.79 x 20.0
