seanmason/skadis-designs/animation/v03-reveal/meshes/053.stl

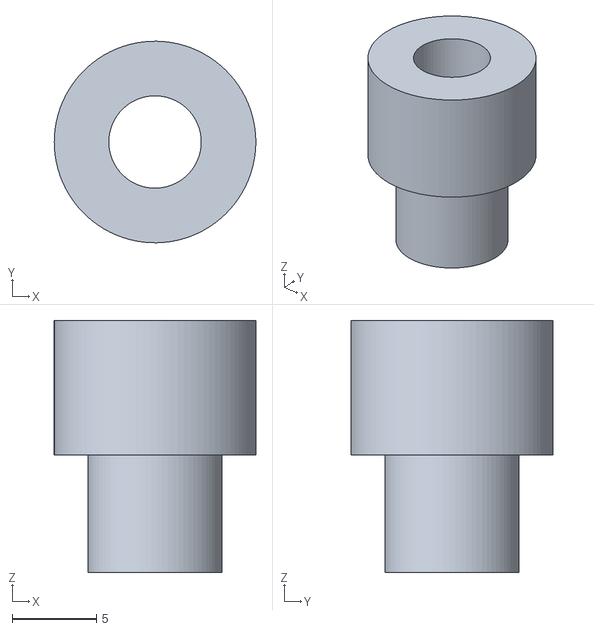
[picture p53: CAD file, 2026-10-29]
animation/v03-reveal/meshes/053.stl
12.0 x 12.0 x 15.0
