seanmason/skadis-designs/(list of files, cad)

Other CAD files:
animation/v07-assembly/meshes/part-042.stl
models/mounting-study/Centered-M2.stl
models/v061/fit-kit/fit-kit-plate.3mf
models/mounting-study/Original-M2.stl
animation/v03-reveal/meshes/045.stl
animation/v03-reveal/meshes/022.stl
animation/v07-assembly/meshes/part-032.stl
animation/v03-reveal/meshes/075.stl
animation/v03-reveal/meshes/050.stl
animation/v07-assembly/assets/axial-mosaic-tile--COLOR-pixel-lower.stl
animation/v07-assembly/meshes/part-010.stl
animation/v03-reveal/meshes/100.stl
animation/v07-assembly/assets/panel-handling-tool-concept--PRINT-quarter-turn-key-handlePitch.stl
animation/v07-assembly/meshes/part-038.stl
animation/v07-assembly/assets/panel-handling-tool-concept--PRINT-thumb-knob-handlePitch.stl
animation/v07-assembly/meshes/part-034.stl
animation/v03-reveal/meshes/083.stl
animation/v07-assembly/assets/panel-handling-tool-concept--REFERENCE-handle-M2x6-0-mm.stl
animation/v07-assembly/meshes/part-019.stl
animation/v07-assembly/meshes/part-047.stl
animation/v03-reveal/meshes/059.stl
animation/v07-assembly/meshes/part-027.stl
animation/v03-reveal/meshes/056.stl
animation/v07-assembly/meshes/part-023.stl
animation/v03-reveal/meshes/074.stl
animation/v07-assembly/meshes/part-037.stl
animation/v07-assembly/meshes/part-013.stl
animation/v03-reveal/meshes/034.stl
animation/v07-assembly/meshes/part-011.stl
animation/v03-reveal/meshes/077.stl
animation/v03-reveal/meshes/067.stl
animation/v07-assembly/meshes/part-003.stl
animation/v03-reveal/meshes/019.stl
animation/v07-assembly/meshes/part-043.stl
animation/v03-reveal/meshes/118.stl
animation/v07-assembly/meshes/part-008.stl
animation/v03-reveal/meshes/107.stl
animation/v07-assembly/meshes/part-041.stl
animation/v03-reveal/meshes/080.stl
animation/v07-assembly/meshes/part-033.stl
animation/v03-reveal/meshes/116.stl
animation/v07-assembly/meshes/part-028.stl
animation/v03-reveal/meshes/026.stl
animation/v03-reveal/meshes/031.stl
animation/v07-assembly/meshes/part-048.stl
animation/v03-reveal/meshes/004.stl
animation/v07-assembly/meshes/part-024.stl
animation/v03-reveal/meshes/086.stl
animation/v07-assembly/meshes/part-039.stl
animation/v03-reveal/meshes/057.stl
animation/v07-assembly/meshes/part-009.stl
animation/v03-reveal/meshes/003.stl
animation/v07-assembly/meshes/part-044.stl
animation/v03-reveal/meshes/096.stl
animation/v07-assembly/meshes/part-000.stl
animation/v03-reveal/meshes/111.stl
animation/v07-assembly/meshes/part-005.stl
animation/v03-reveal/meshes/023.stl
animation/v07-assembly/meshes/part-035.stl
animation/v03-reveal/meshes/065.stl
animation/v07-assembly/meshes/part-002.stl
animation/v03-reveal/meshes/033.stl
animation/v07-assembly/meshes/part-018.stl
animation/v03-reveal/meshes/000.stl
animation/v07-assembly/meshes/part-007.stl
animation/v03-reveal/meshes/006.stl
animation/v07-assembly/meshes/part-040.stl
animation/v03-reveal/meshes/104.stl
animation/v07-assembly/meshes/part-020.stl
animation/v03-reveal/meshes/043.stl
animation/v07-assembly/meshes/part-025.stl
animation/v03-reveal/meshes/082.stl
animation/v07-assembly/meshes/part-031.stl
animation/v03-reveal/meshes/024.stl
animation/v07-assembly/meshes/part-021.stl
animation/v03-reveal/meshes/015.stl
animation/v07-assembly/meshes/part-029.stl
animation/v03-reveal/meshes/097.stl
animation/v07-assembly/meshes/part-016.stl
animation/v03-reveal/meshes/036.stl
animation/v07-assembly/meshes/part-022.stl
animation/v03-reveal/meshes/055.stl
animation/v07-assembly/meshes/part-030.stl
animation/v03-reveal/meshes/112.stl
animation/v07-assembly/meshes/part-006.stl
animation/v03-reveal/meshes/091.stl
animation/v07-assembly/meshes/part-045.stl
animation/v03-reveal/meshes/105.stl
animation/v07-assembly/meshes/part-014.stl
animation/v03-reveal/meshes/021.stl
animation/v03-reveal/meshes/038.stl
animation/v03-reveal/meshes/044.stl
animation/v03-reveal/meshes/092.stl
animation/v03-reveal/meshes/016.stl
animation/v03-reveal/meshes/094.stl
animation/v03-reveal/meshes/013.stl
animation/v03-reveal/meshes/037.stl
animation/v03-reveal/meshes/001.stl
animation/v03-reveal/meshes/064.stl
animation/v03-reveal/meshes/020.stl
animation/v03-reveal/meshes/046.stl
animation/v03-reveal/meshes/089.stl
animation/v03-reveal/meshes/047.stl
animation/v03-reveal/meshes/099.stl
animation/v03-reveal/meshes/002.stl
animation/v03-reveal/meshes/058.stl
animation/v03-reveal/meshes/076.stl
animation/v03-reveal/meshes/032.stl
animation/v03-reveal/meshes/098.stl
animation/v03-reveal/meshes/063.stl
animation/v03-reveal/meshes/095.stl
animation/v03-reveal/meshes/025.stl
animation/v03-reveal/meshes/039.stl
animation/v03-reveal/meshes/108.stl
animation/v03-reveal/meshes/040.stl
animation/v03-reveal/assembly-480.f3d
animation/v03-reveal/meshes/005.stl
animation/v03-reveal/meshes/007.stl
animation/v03-reveal/meshes/008.stl
animation/v03-reveal/meshes/009.stl
animation/v03-reveal/meshes/010.stl
animation/v03-reveal/meshes/012.stl
animation/v03-reveal/meshes/014.stl
animation/v03-reveal/meshes/017.stl
animation/v03-reveal/meshes/018.stl
animation/v03-reveal/meshes/028.stl
animation/v03-reveal/meshes/030.stl
animation/v03-reveal/meshes/035.stl
animation/v03-reveal/meshes/041.stl
animation/v03-reveal/meshes/042.stl
animation/v03-reveal/meshes/048.stl
animation/v03-reveal/meshes/049.stl
animation/v03-reveal/meshes/051.stl
animation/v03-reveal/meshes/052.stl
animation/v03-reveal/meshes/054.stl
animation/v03-reveal/meshes/060.stl
animation/v03-reveal/meshes/061.stl
animation/v03-reveal/meshes/062.stl
animation/v03-reveal/meshes/066.stl
animation/v03-reveal/meshes/068.stl
animation/v03-reveal/meshes/069.stl
animation/v03-reveal/meshes/070.stl
animation/v03-reveal/meshes/071.stl
animation/v03-reveal/meshes/072.stl
animation/v03-reveal/meshes/073.stl
animation/v03-reveal/meshes/078.stl
animation/v03-reveal/meshes/079.stl
animation/v03-reveal/meshes/084.stl
animation/v03-reveal/meshes/085.stl
animation/v03-reveal/meshes/088.stl
animation/v03-reveal/meshes/090.stl
animation/v03-reveal/meshes/093.stl
animation/v03-reveal/meshes/101.stl
animation/v03-reveal/meshes/103.stl
animation/v03-reveal/meshes/106.stl
animation/v03-reveal/meshes/109.stl
animation/v03-reveal/meshes/110.stl
animation/v03-reveal/meshes/114.stl
animation/v03-reveal/meshes/115.stl
animation/v03-reveal/meshes/117.stl
animation/v03-reveal/meshes/119.stl
animation/v03-reveal/reveal.blend
animation/v04-metallic/metallic.blend
animation/v04-review/review.blend
animation/v05-smooth/smooth.blend
animation/v07-assembly/assembly.blend
models/bridge-horizontal.stl
models/bridge-vertical.stl
models/coupon-assembly-2x2-fixed80.f3d
models/infinite-skadis-hd-v01.f3d
models/mounting-study/mounting-comparison.f3d
models/panel-240x240.stl
models/panel-fit-coupon-80x80.stl
models/v02/alignment-key-horizontal.step
models/v02/alignment-key-horizontal.stl
models/v02/alignment-key-vertical.step
models/v02/alignment-key-vertical.stl
models/v02/frame-assembly-v02.f3d
models/v02/frame-assembly-v02.step
models/v02/ll-panel-120.step
models/v02/ll-panel-120.stl
models/v02/lr-panel-120.step
models/v02/lr-panel-120.stl
models/v02/metal-cap.step
models/v02/metal-compression-spacer.step
models/v02/metal-splice-end.step
models/v02/metal-splice-middle.step
models/v02/metal-wall-standoff-left.step
models/v02/metal-wall-standoff-right.step
models/v02/panel-bottom-edge-120.step
models/v02/panel-bottom-edge-120.stl
models/v02/panel-bottom-edge-v02.f3d
models/v02/panel-interior-120.step
models/v02/panel-interior-120.stl
models/v02/panel-interior-v02.f3d
models/v02/panel-left-edge-120.step
models/v02/panel-left-edge-120.stl
models/v02/panel-left-edge-v02.f3d
models/v02/panel-right-edge-120.step
models/v02/panel-right-edge-120.stl
models/v02/panel-right-edge-v02.f3d
models/v02/panel-standalone-120.step
models/v02/panel-standalone-120.stl
models/v02/panel-standalone-v02.f3d
models/v02/panel-top-edge-120.step
models/v02/panel-top-edge-120.stl
models/v02/panel-top-edge-v02.f3d
models/v02/rear-bearing-seat.step
models/v02/rear-bearing-seat.stl
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
