seanmason/skadis-designs/models/v061/fit-kit/mk4s-print-record.md

# MK4S v0.6.1 print — 2026-11-03

Prepared in PrusaSlicer 2.9.6 for MK4S/MMU3, 0.4 mm nozzle, black Bambu PLA Basic in slot 1. Generic PLA @MK4S base; 0.20 mm STRUCTURAL, four perimeters, four top/bottom layers, 20% infill. Supports automatically generated from the bed only; 0.20 mm support contact gap. Only T0 is used; no wipe tower.

The two hook tiles are side-oriented so bed supports reach the hook and avoid the throat's board-contact surface. Panels are face-down; carrier is rail-side down. Preview shows supports under both hook tiles. Five pieces total.

Final CLI estimate: 56m32s, 14.30 g. GUI rounds to 57 minutes. Configured project: skadis-v061-mk4s-side.3mf. Standalone G-code: skadis-v061-mk4s-slot1.gcode. Settings: mk4s-04.ini.

Connect reports the printer FINISHED, with 0.4 mm high-flow nozzle and no diameter mismatch. The standard 0.4 mm profile is used conservatively. User confirmed plate clear and slot 1 loaded.

Status: launch verified. User completed the Connect launch; file transfer completed. A printer firmware recommendation temporarily held startup; Continue was selected without updating firmware. Connect then reported PRINTING for skadis-v061-mk4s-side_0.4n_0.2mm_PLA_MK4SMMU3_57m.gcode, with nozzle heating (69 toward 170 C startup target), bed heating (27 toward 60 C), and 55 minutes remaining. First-layer quality and completed physical print are not yet verified.
