seanmason/skadis-designs/animation/v04-metallic/assembled.png

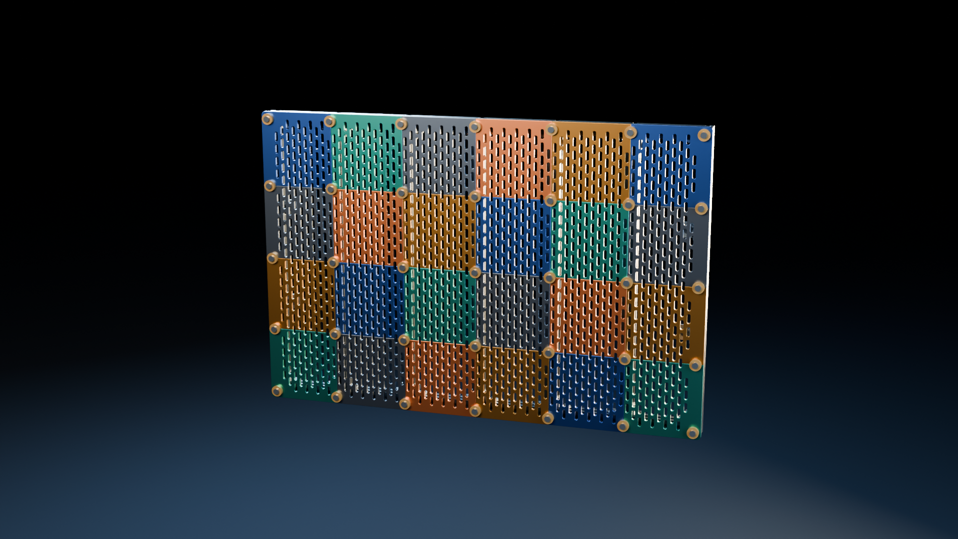
animation/v04-metallic/assembled.png
