seanmason/skadis-designs/animation/v04-review/assembled.png

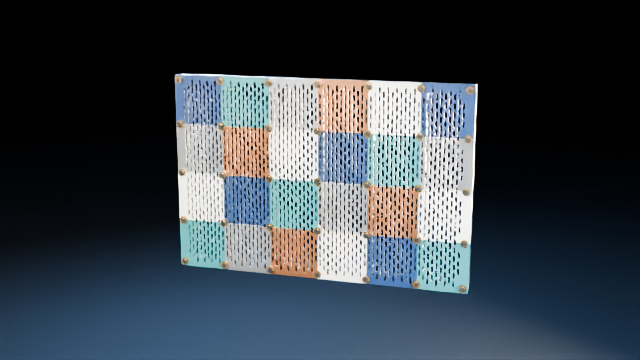
animation/v04-review/assembled.png
