seanmason/skadis-designs/animation/v07-assembly/captions/art.png

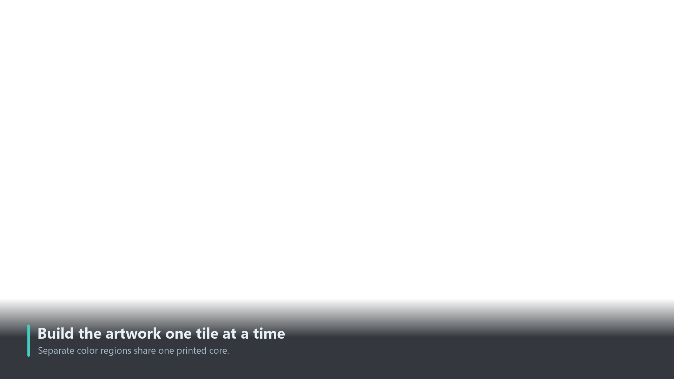
animation/v07-assembly/captions/art.png
