seanmason/skadis-designs/animation/v07-assembly/contact-sheet.jpg

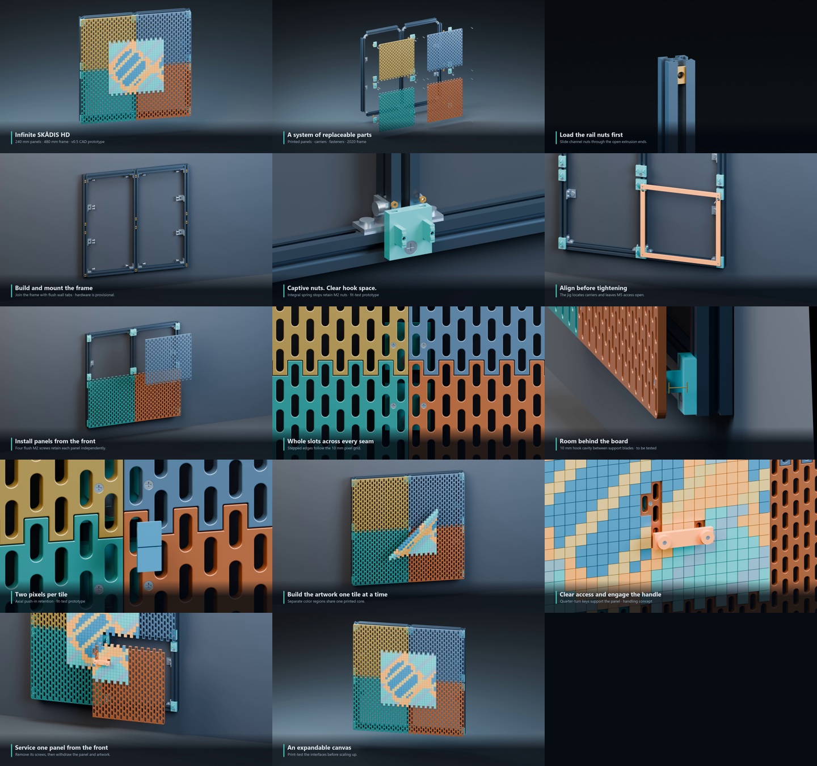
animation/v07-assembly/contact-sheet.jpg
