seanmason/skadis-designs/animation/v07-assembly/ending.jpg

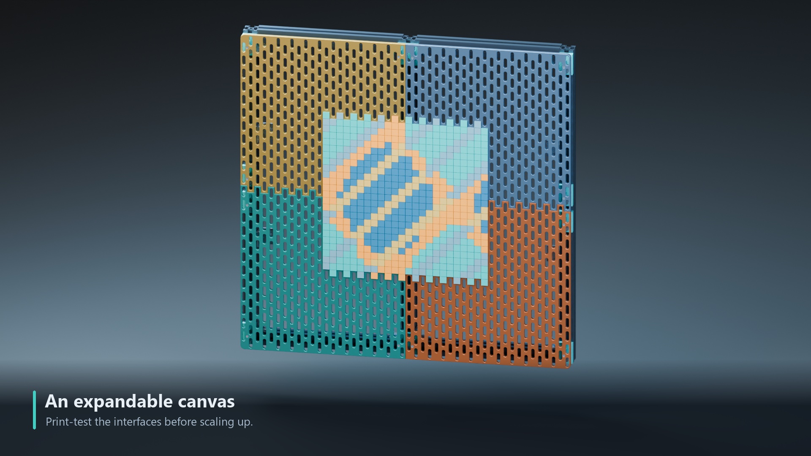
animation/v07-assembly/ending.jpg
