seanmason/skadis-designs/previews/assembly-front.png

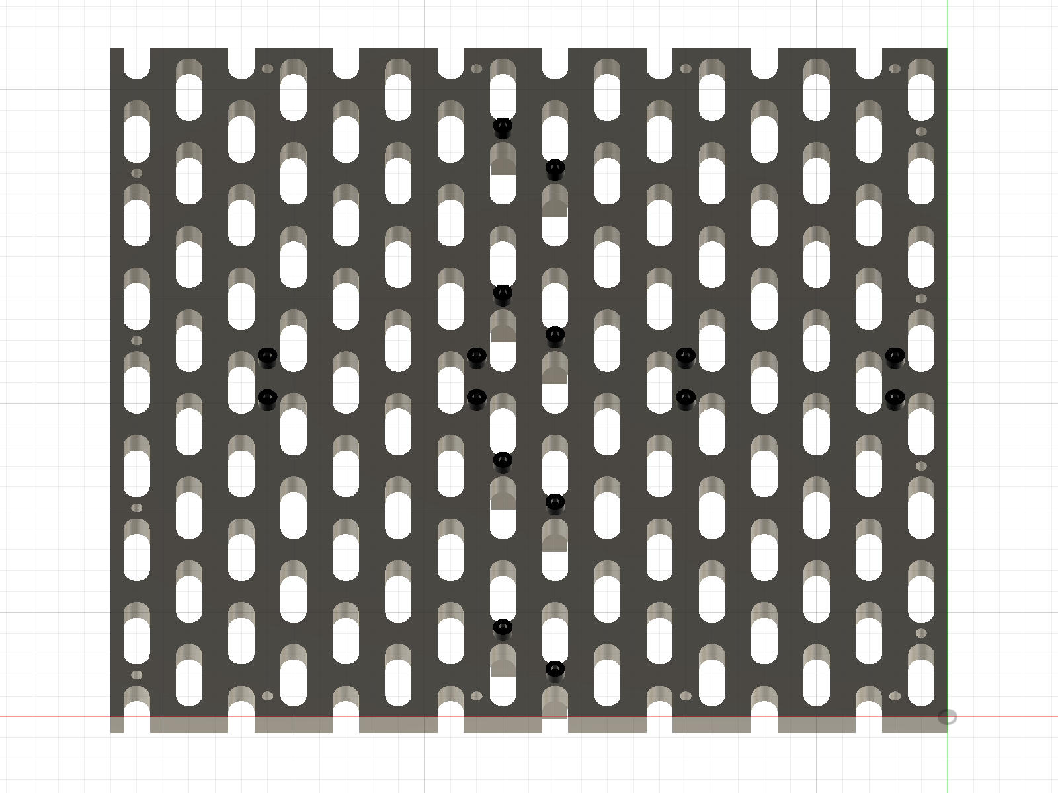
previews/assembly-front.png
