seanmason/skadis-designs/(commit log)

2026-10-27 Add parametric dense SKADIS pegboard prototype and design research
    [bridge-horizontal.step, bridge-horizontal.stl, bridge-vertical.step, bridge-vertical.stl, coupon-assembly-2x2-fixed80.f3d, infinite-skadis-hd-v01.f3d, panel-240x240.step, panel-240x240.stl]
2026-10-27 Record finished-edge requirements and recessed extrusion frame proposal
2026-10-27 Set provisional rear hook clearance to 10 mm
2026-10-27 Build parametric v0.2 pegboard and recessed extrusion frame in Fusion
    [alignment-key-horizontal.step, alignment-key-horizontal.stl, alignment-key-vertical.step, alignment-key-vertical.stl, frame-assembly-v02-parameters.csv, frame-assembly-v02.f3d, frame-assembly-v02.step, ll-panel-120.step]
2026-10-28 Revise pegboard frame for flush wall mounting and measured sloped extrusion
    [frame-assembly-v03-parameters.csv, frame-assembly-v03.f3d, frame-assembly-v03.step, ll-panel-120.step, ll-panel-120.stl, lr-panel-120.step, lr-panel-120.stl, metal-cap.step]
2026-10-29 Add CAD-grounded 480 mm pegboard reveal animation and editable scene
    [000.stl, 001.stl, 002.stl, 003.stl, 004.stl, 005.stl, 006.stl, 007.stl]
2026-10-29 Add text-free 24-panel whirlwind animation review draft
    [review.blend]
2026-10-29 Prepare full HD all-metallic reveal and resumable CPU render
    [metallic.blend]
2026-10-29 Fix camera rotation flips and stepped framing; validate regression frames
    [smooth.blend]
2026-10-29 Deliver validated GPU animation with corrected camera and repaired final frame
2026-10-29 Audit intrusive mounts and add clean-face rear-carrier clearance study
    [connector-clearance-study.f3d, connector-clearance-study.step]
2026-10-29 Record preference for small flush front-accessible panel screws
2026-10-29 Add validated flush-screw Skadis frame and panel system v0.4
    [carrier-double.step, carrier-double.stl, carrier-single.step, carrier-single.stl, frame-assembly-v04-parameters.csv, frame-assembly-v04.f3d, frame-assembly-v04.step, nut-keeper.step]
2026-10-30 Recommend 240 mm panels and a 240 by 480 mm frame grid
2026-10-30 Record adversarial design review and next prototype priorities
2026-10-31 Add v0.5 whole-slot panels and assembly test models
    [axial-mosaic-tile--COLOR-pixel-lower.stl, axial-mosaic-tile--COLOR-pixel-upper.stl, axial-mosaic-tile--PRINT-fit-coupon.stl, axial-mosaic-tile--PRINT-tile-core.stl, axial-mosaic-tile-bottom-terminal--COLOR-pixel-lower.stl, axial-mosaic-tile-bottom-terminal--COLOR-pixel-terminal.stl, axial-mosaic-tile-bottom-terminal--COLOR-pixel-upper.stl, axial-mosaic-tile-bottom-terminal--PRINT-fit-coupon.stl]
2026-10-31 Add captioned v0.5 assembly and features animation
    [assembly.blend, axial-mosaic-tile--COLOR-pixel-lower.stl, axial-mosaic-tile--COLOR-pixel-upper.stl, axial-mosaic-tile--PRINT-tile-core.stl, carrier-jig-240--PRINT-alignment-jig.stl, panel-handling-tool-concept--PRINT-handle-bridge.stl, panel-handling-tool-concept--PRINT-quarter-turn-key-0-mm.stl, panel-handling-tool-concept--PRINT-quarter-turn-key-handlePitch.stl]
2026-11-01 Document mounting weakness, CAD alternatives and local hardware availability
    [Centered-M2.stl, Original-M2.stl, Solid-land-M3.stl, mounting-comparison.f3d]
2026-11-01 Revise assembly and jig to centered M2 prototype with clearance audit
    [PRINT-carrier-00-single.step, PRINT-carrier-00-single.stl, PRINT-carrier-01-single.step, PRINT-carrier-01-single.stl, PRINT-carrier-02-single.step, PRINT-carrier-02-single.stl, PRINT-carrier-10-double.step, PRINT-carrier-10-double.stl]
2026-11-01 Add compact v0.6 mounting seam and mosaic fit-test kit
    [01-mount-coupon.stl, 02-seam-mate.stl, 03-single-carrier.stl, 04-two-pixel-tile.stl, fit-kit-plate.3mf, fit-kit-v06.f3d, fit-kit-v06.step]
2026-11-03 Prepare v0.6 fit kit for MK4S MMU3 0.4 mm PLA printing
    [skadis-fit-mk4s-04.3mf]
2026-11-04 Revise fit kit with front-removable drop hooks and snugger interfaces
    [01-mount-coupon.stl, 02-seam-mate.stl, 03-single-carrier.stl, 04-two-pixel-tile.stl, fit-kit-plate.3mf, fit-kit-v061.f3d, fit-kit-v061.step]
2026-11-04 Slice revised fit kit for MK4S with supported side-oriented hooks
    [fit-kit-plate.3mf, skadis-v061-mk4s-side.3mf]
2026-11-04 Record verified MK4S fit-kit print startup
